MightyMirko/SS2018_HIT_web/CSS/readme.txt

1. Extras.css in Ordner CSS kopieren.

2. CSS in Vorlage einfügen - Die letzte Zeile:

<link href="CSS/Design.css" media="screen" rel="stylesheet" type="text/css" />
<link href="CSS/default.css" media="print" rel="stylesheet" type="text/css" />
<link href="CSS/Extras.css" media="screen" rel="stylesheet" type="text/css" />

3. Bild einfügen:

<p class="iimageFrame">
	Error
	<br>BILDUNTERSCHRIFT
</p>
