MightyMirko/SS2018_HIT_web/data/180307_blackbox.pptx

System1
Output
Input
Störung
Restriktionen
EMV
Förderband 0/1
VDE
Geld
Luft
Daten
Warme Luft
Versorgung 230V
Datenüber-tragung

Energie

Signal

Stoff

## Slide 2

Schuko Steckdosenleiste 230V mit USB 5A

Schaltnetzteil 230V/24V 7.5A

24
5
3.3
PE

Control box

Platine

ESP32-2

ESP32-1

4x
Relais
Shield

## Slide 3

Steuerungspanel

OLED Display

OLED Display

Poti
Taster

SD CARD

SD CARD

## Slide 4

NOT AUS

## Slide 5

HAUPT SCHALTER

## Slide 6

System1
Output
Input
Störung
Restriktionen
EMV
Förderband 0/1
VDE
24V
Geld
Kalte Luft
Temperatur, Luftfeuchte, Drucker Taster 1,2
Warme Luft
Versorgung 230V
Datenübertragung

Energie

Signal

Stoff

## Slide 7

Daten

Energie

SPS
Förderband

FI

Not Aus

Haupt-schalter

Endschalter = 1

Drucker

Schalt-schrank

Messwerte

Display

Poti

SD Card
