MightyMirko/SS2018_HIT_web/data/aa_ss18/180307_blackbox.pptx

System1
Output
Input
Störung
Restriktionen
EMV
Förderband 0/1
VDE
Geld
Luft
Daten
Warme Luft
Versorgung 230V
Datenübertragung

Energie

Signal

Stoff

## Slide 2

NOT AUS

## Slide 3

HAUPT SCHALTER

## Slide 4

Schuko Steckdosenleiste 230V mit USB 5A

Schaltnetzteil 230V/24V 7.5A

24
5
3.3
PE

Control box

Platine

ESP32-2

ESP32-1

4x
Relais
Shield

## Slide 5

Steuerungspanel

OLED Display

OLED Display

Poti
Taster

SD CARD

SD CARD

## Slide 6

System1
Output
Input
Störung
Restriktionen
EMV
Förderband 0/1
VDE
24V
Geld
Kalte Luft
Temperatur, Luftfeuchte, Drucker Taster 1,2
Warme Luft
Versorgung 230V
Datenübertragung

Energie

Signal

Stoff
