MightyMirko/SS2018_HIT_web/data/20180405_eagle_platinenMajo_rev1/layer.png

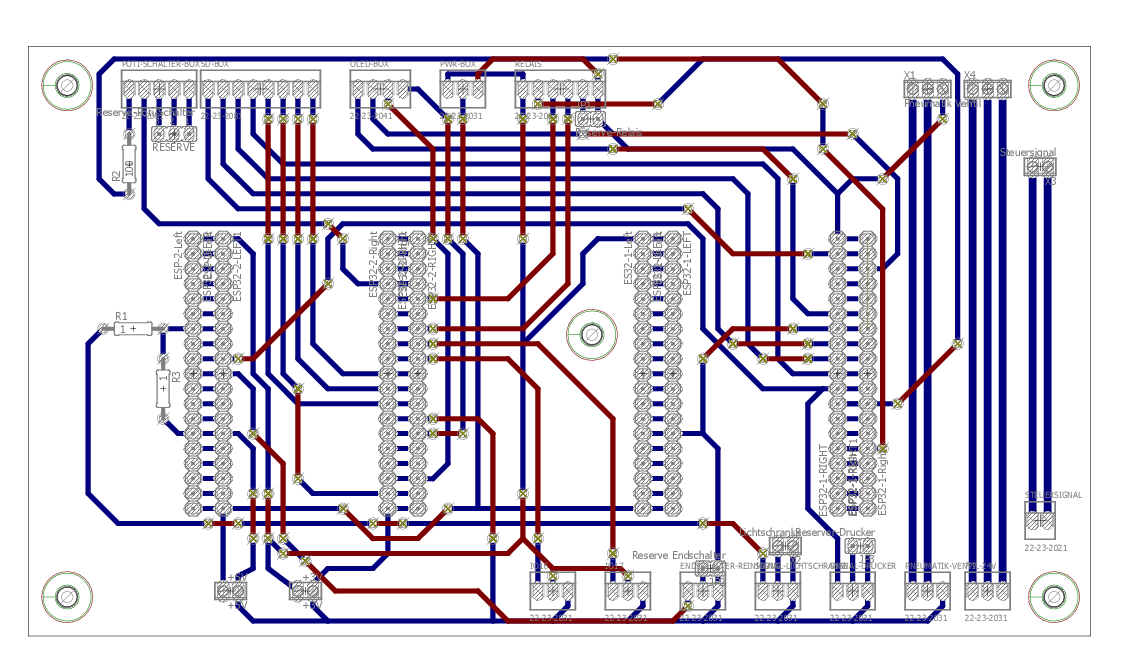
data/20180405_eagle_platinenMajo_rev1/layer.png
