MightyMirko/SS2018_HIT_web/data/20180520_eagle_platinenMajo_rev2/Schaltplan.PNG

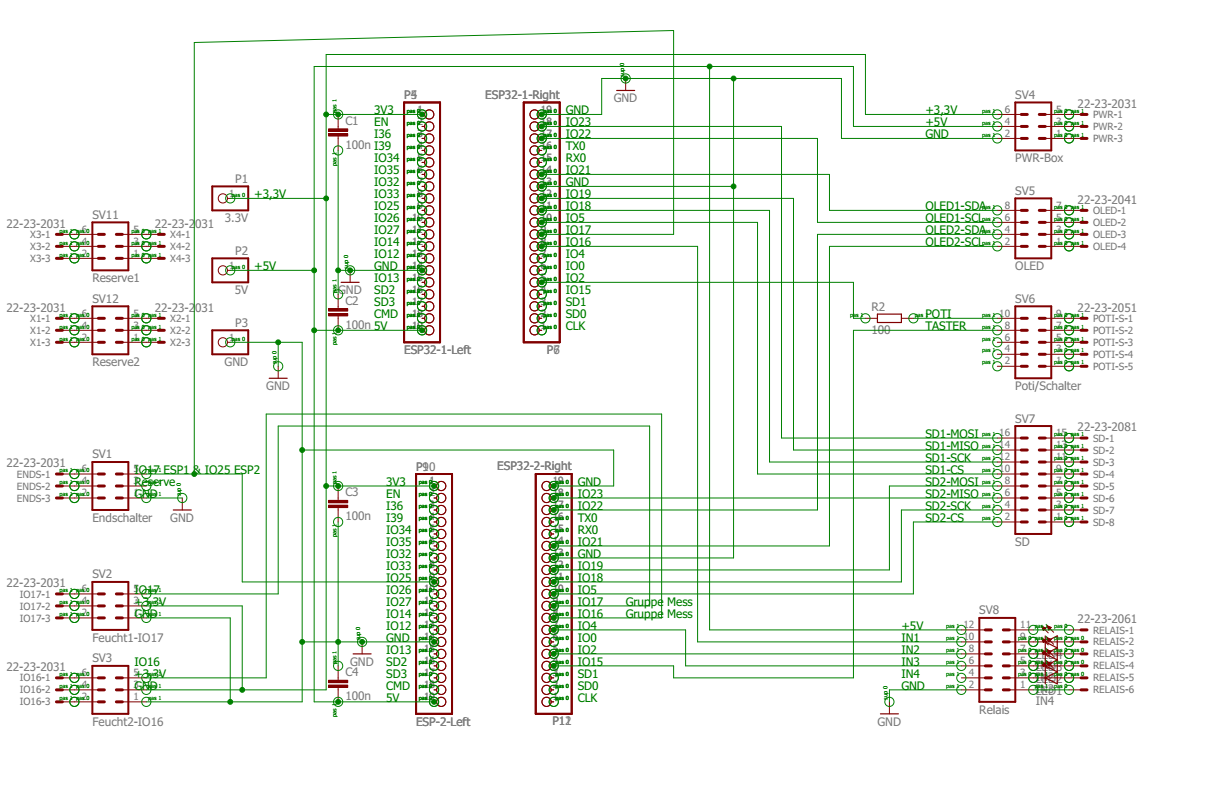
data/20180520_eagle_platinenMajo_rev2/Schaltplan.PNG
