MightyMirko/SS2018_HIT_web/data/20180520_eagle_platinenMajo_rev2/Uebersicht-mitLED.PNG

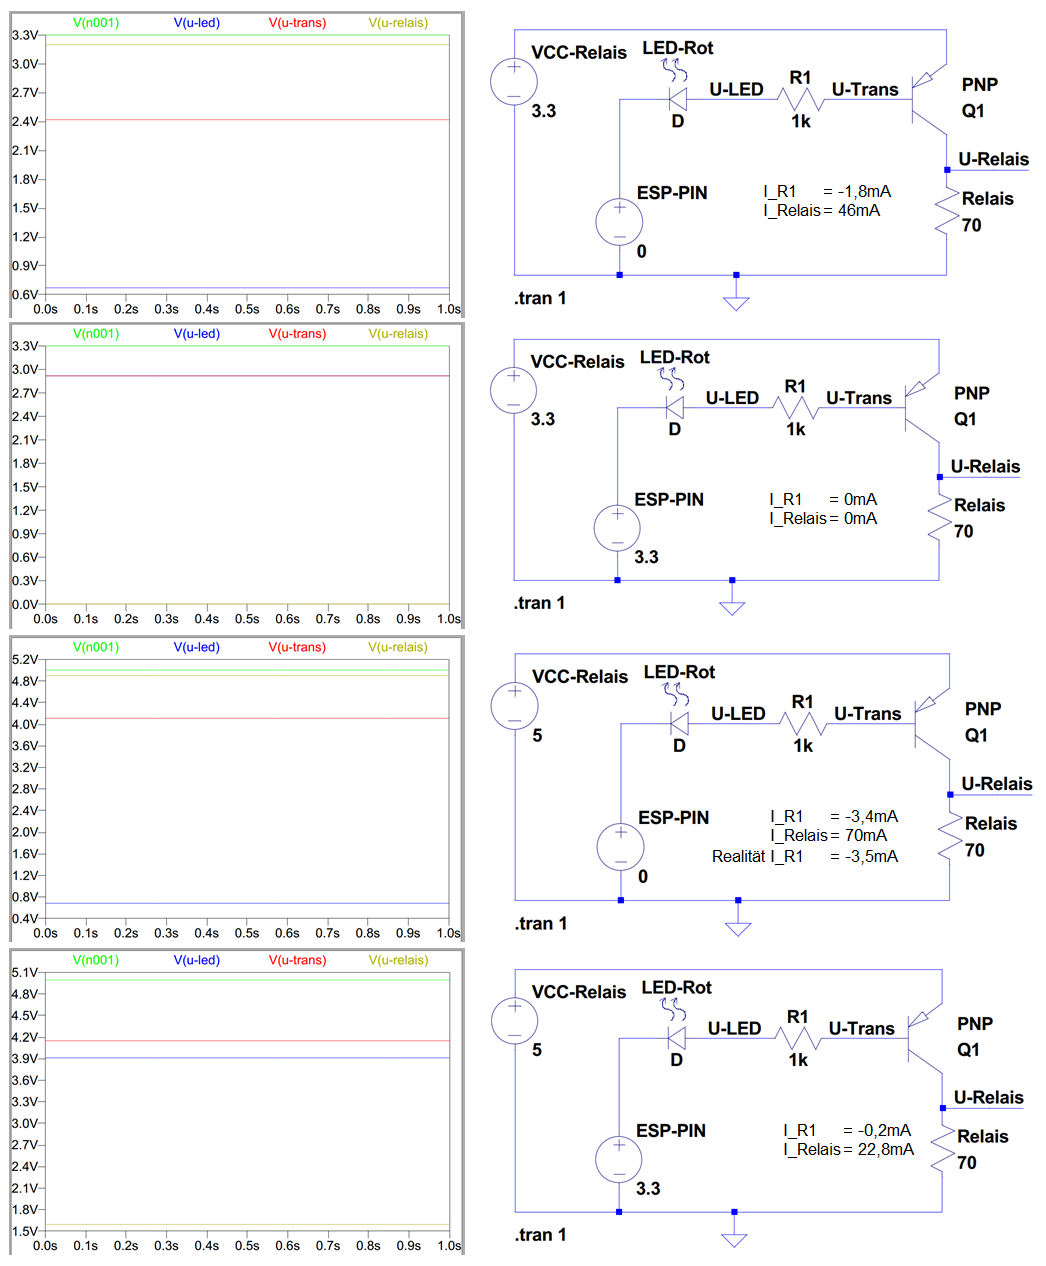
data/20180520_eagle_platinenMajo_rev2/Uebersicht-mitLED.PNG
