MightyMirko/SS2018_HIT_web/images/AA_ss18/20180306_kickoff.jpg

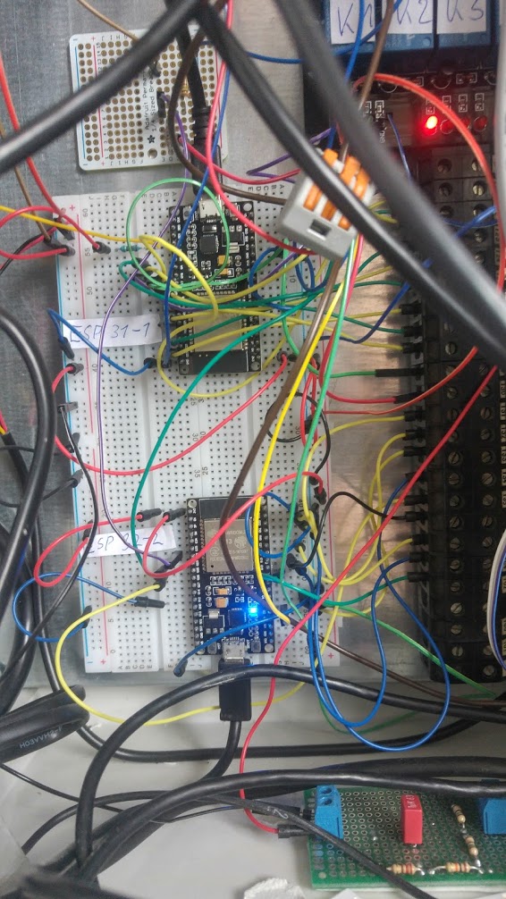
images/AA_ss18/20180306_kickoff.jpg
