MightyMirko/SS2018_HIT_web/images/AA_ss18/20180418_blackbox/Folie3.PNG

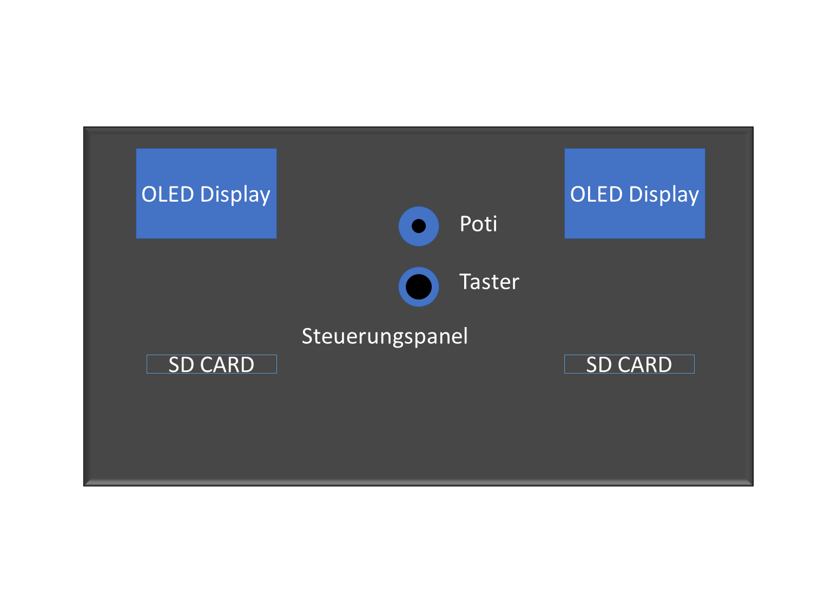
images/AA_ss18/20180418_blackbox/Folie3.PNG
