MightyMirko/SS2018_HIT_web/images/AA_ss18/20180418_blackbox/Folie7.PNG

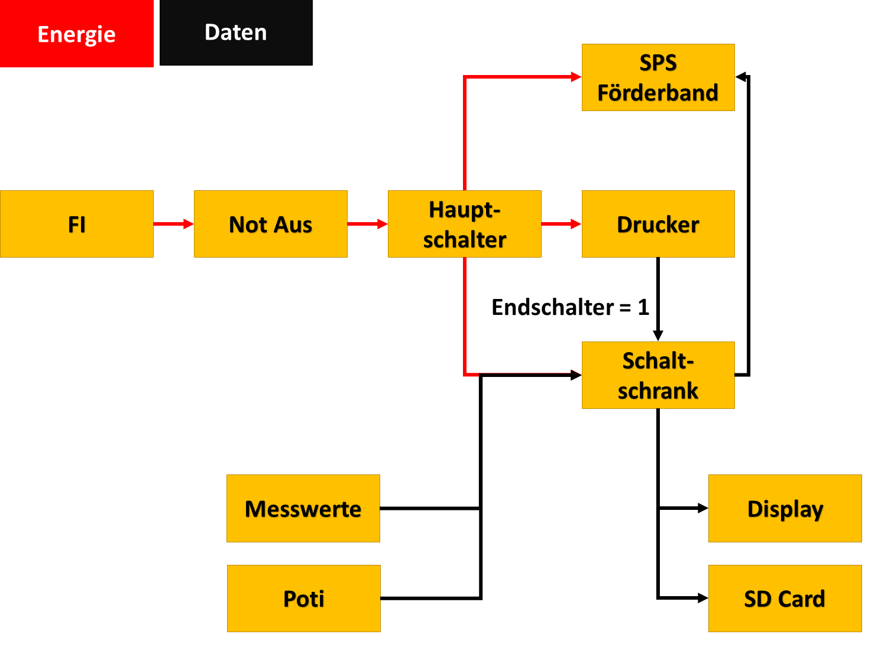
images/AA_ss18/20180418_blackbox/Folie7.PNG
