MightyMirko/SS2018_HIT_web/images/AA_ss18/20180418_Majolika-brainstorming.png

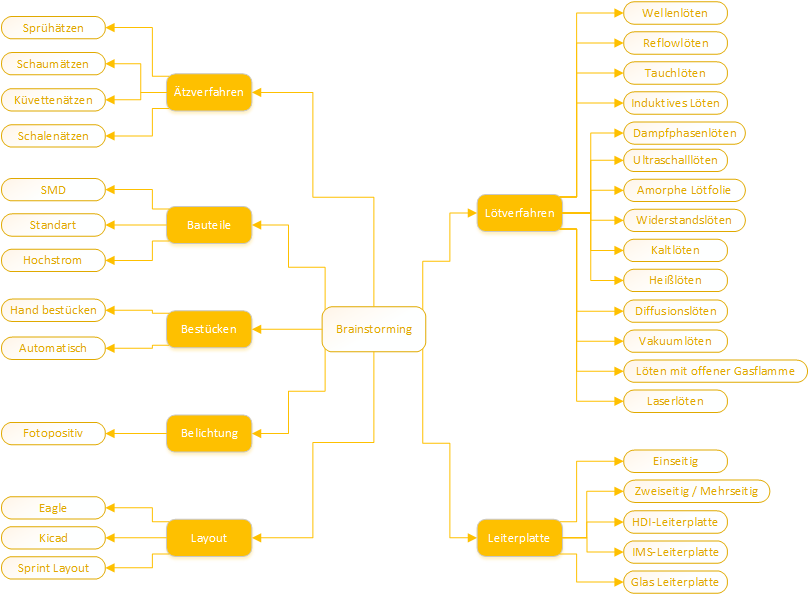
images/AA_ss18/20180418_Majolika-brainstorming.png
