MightyMirko/SS2018_HIT_web/images/AA_ss18/20180430_FinalCountdown/platine_top_placed.jpg

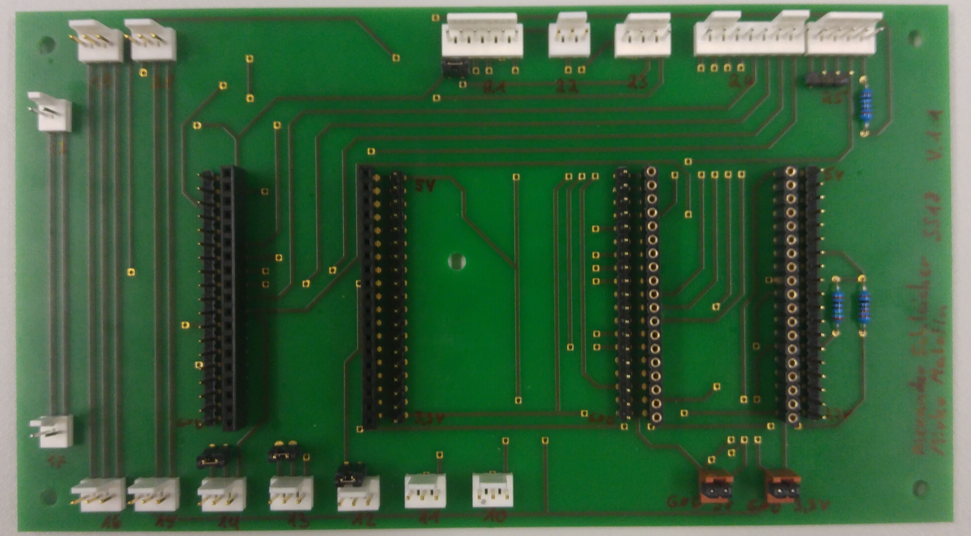
images/AA_ss18/20180430_FinalCountdown/platine_top_placed.jpg
