MightyMirko/SS2018_HIT_web/images/AA_ss18/20180430_FinalCountdown/schaltkasten_.jpg

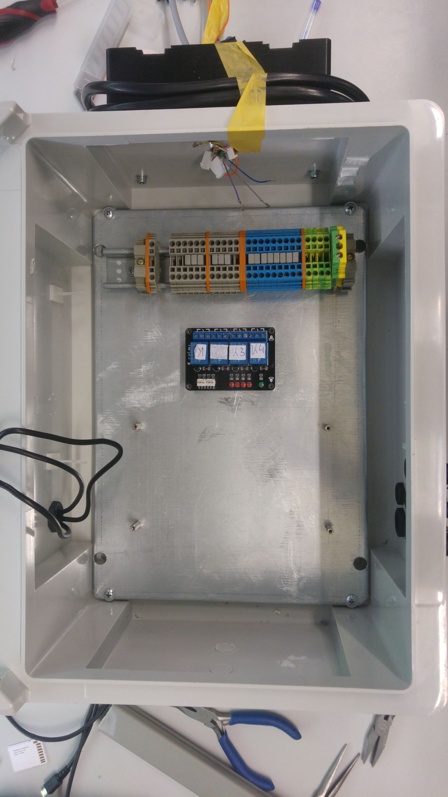
images/AA_ss18/20180430_FinalCountdown/schaltkasten_.jpg
