MightyMirko/SS2018_HIT_web/images/AA_ss18/Alex.png

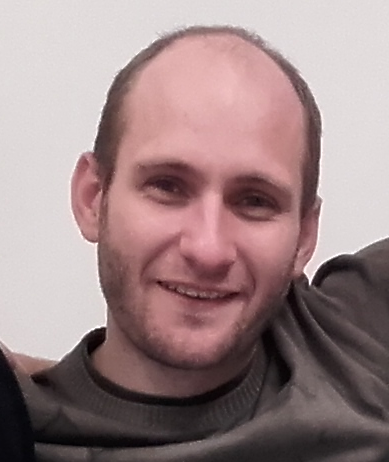
images/AA_ss18/Alex.png
