MightyMirko/SS2018_HIT_web/images/AA_ss18/blackbelt3d.png

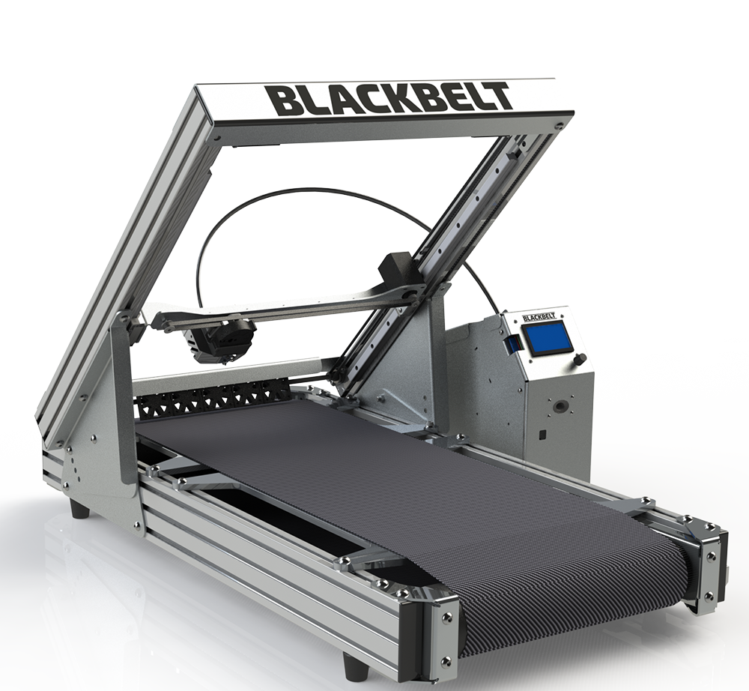
images/AA_ss18/blackbelt3d.png
