MightyMirko/SS2018_HIT_web/images/AA_ss18/blackbox.png

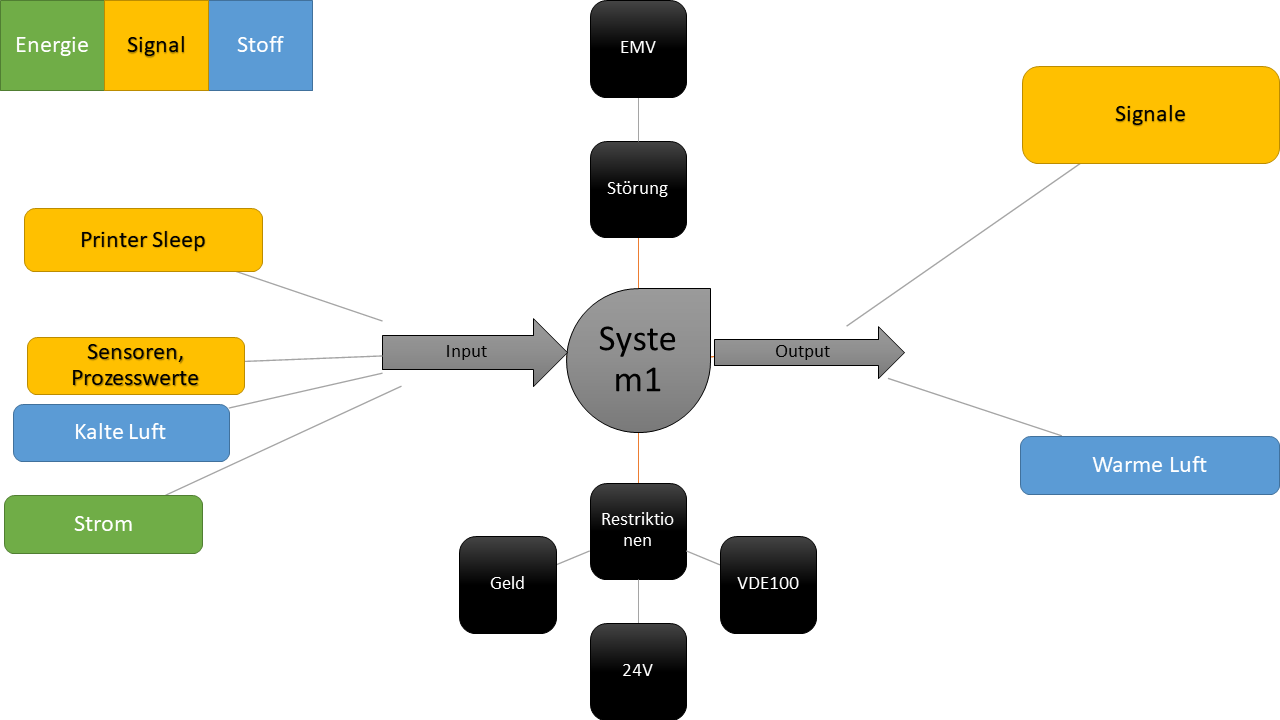
images/AA_ss18/blackbox.png
