MightyMirko/SS2018_HIT_web/images/AA_ss18/Delta-WASP-2040.jpg

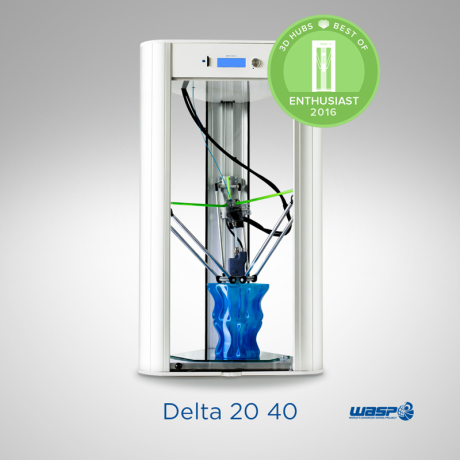
images/AA_ss18/Delta-WASP-2040.jpg
