MightyMirko/SS2018_HIT_web/images/AA_ss18/Mirko_Matosin.jpg

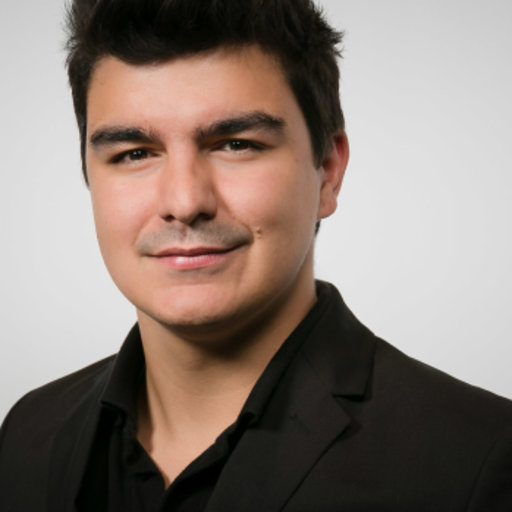
images/AA_ss18/Mirko_Matosin.jpg
