MightyMirko/SS2018_HIT_web/images/AA_ss18/P1010303.JPG

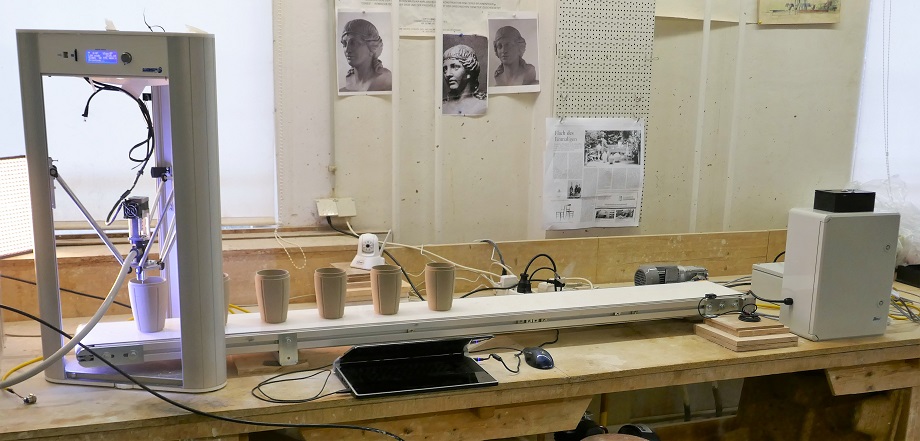
images/AA_ss18/P1010303.JPG
