MightyMirko/SS2018_HIT_web/images/AA_ss18/SimplePro_HeatedBed.Main_.png

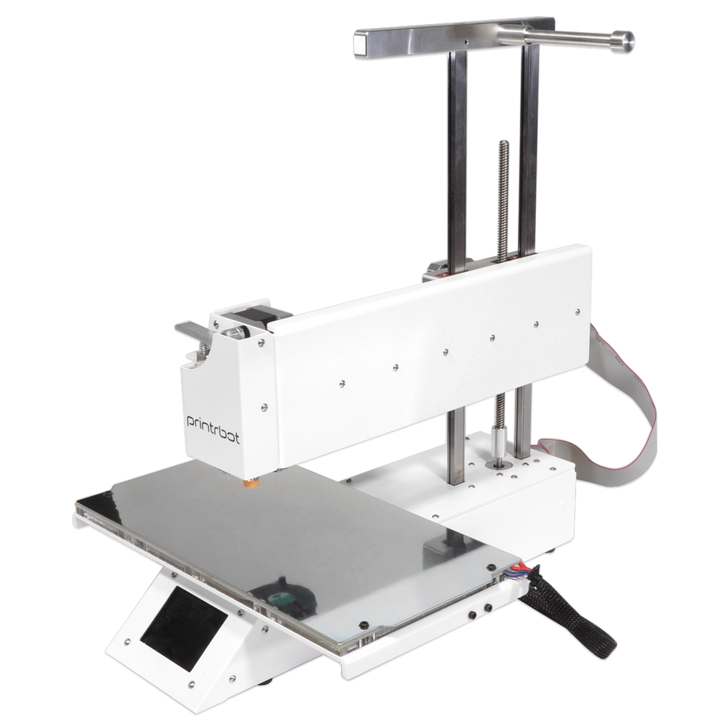
images/AA_ss18/SimplePro_HeatedBed.Main_.png
