MightyMirko/SS2018_HIT_web/images/AA_ss18/Ultimaker.jpg

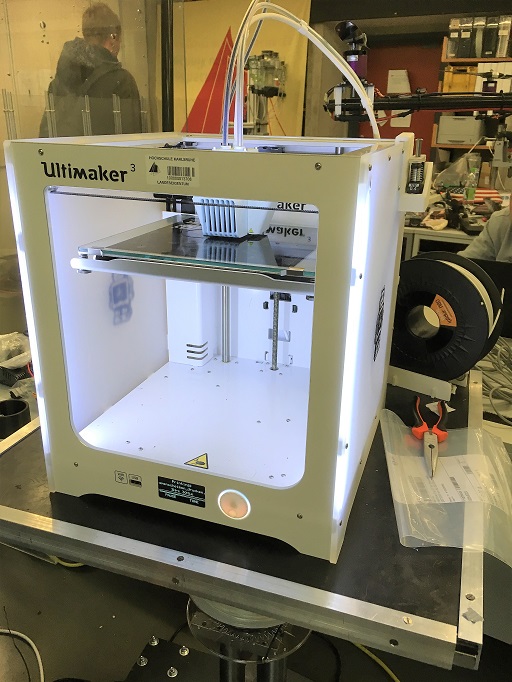
images/AA_ss18/Ultimaker.jpg
