MightyMirko/SS2018_HIT_web/images/netzteil.jpg

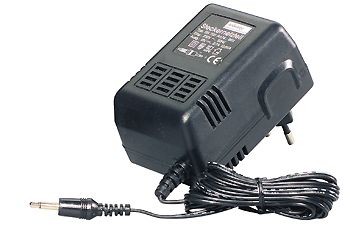
images/netzteil.jpg
