MightyMirko/SS2018_HIT_web/images/platine-brd.png

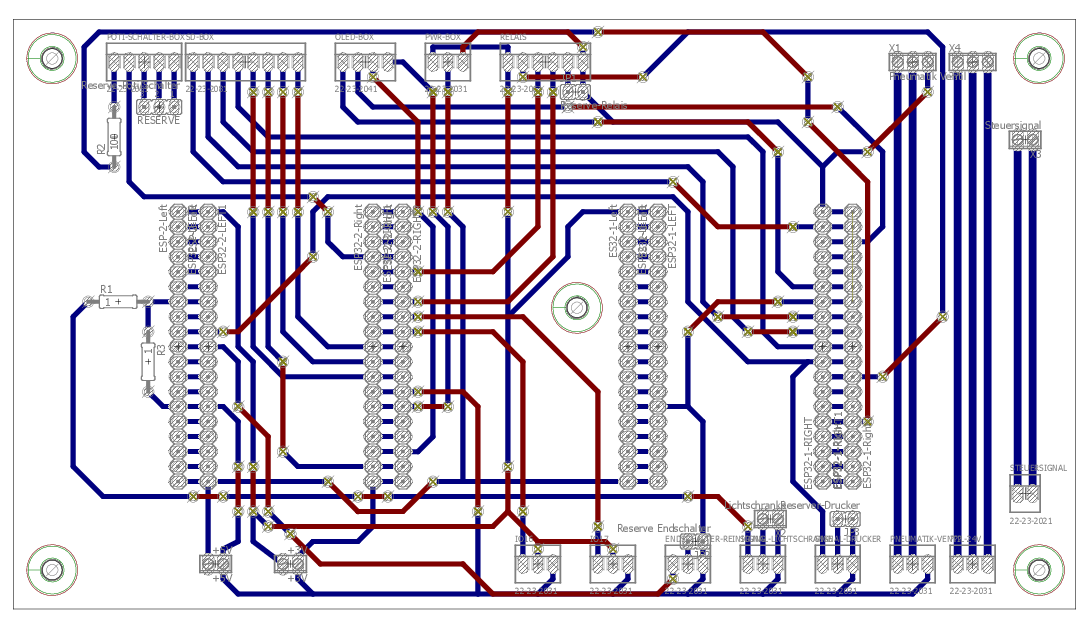
images/platine-brd.png
