MightyMirko/SS2018_HIT_web/images/platine.png

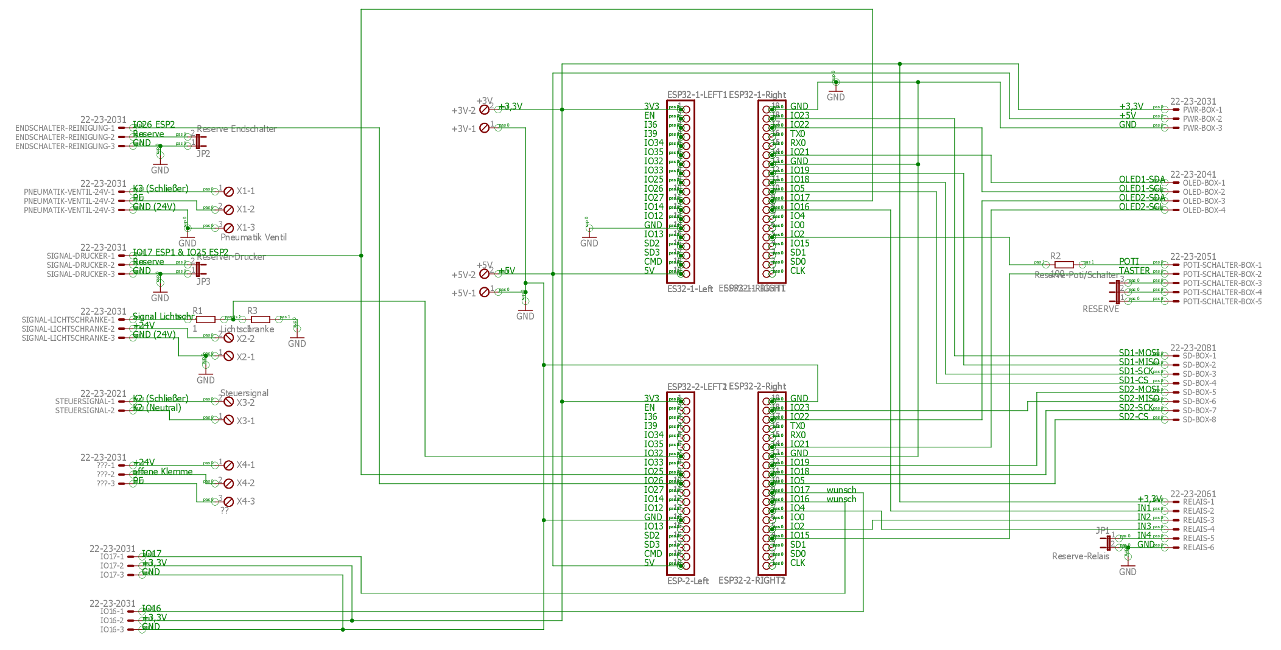
images/platine.png
