MightyMirko/SS2018_HIT_web/data/aa_ss18/20180520_bom_platineMajo_rev2.pdf

Pos. | Anz. Firma | Bezeichnung
1 | 150 | Molex | KK - Buchse, Crimpkontakt, für Serie 2759 AWG 30-22
2 | 6 | Molex | 1x3 Crimpgehäuse, 2.54mm
3 | 10 | Molex | 1x3 Stifleiste, 2.54mm
4 | 4 | Molex | 1x4 Stiftleiste, 2.54mm
5 | 4 | Molex | 1x5 Stiftleiste, 2.54mm
6 | 4 | Molex | 1x6 Stiftleiste, 2.54mm
7 | 4 | Molex | 1x8 Stiftleiste, 2.54mm
8 | 4 | Reichelt | Stiftleisten 2,54 mm, 2x50, gerade
9 | 6 | Reichelt | Stiftleisten 2,54 mm, 1X50, gerade
10 | 5 | Reichelt | Buchsenleisten 2,54 mm, 1X50, gerade
11 | 50 | Reichelt | Kurzschlussbrücke (Jumper), schwarz, RM 2,54
12 | 5 | Yageo | Folienkondensator, 100nF, 100V, 100°C
13 | 5 | Reichelt | LED, 3 mm, bedrahtet, 5 V, rot, 20 mcd, 60°
| | Gesamtsumme ohne MwSt
| | Gesamtsumme mit MwSt
15 | 1 PSK | | Crimpzange PSK AWG18...22 (0.30...0.80 mm²) und
16 | 2 Carry | | Stiftleisten 2,54 mm, 1X36, gerade
17 | 1 Carry | | Buchsenleisten 2,54 mm, 1X50, gerade
18 | 10 Reichelt | | Kurzschlussbrücke, schwarz, RM 2,54
19 | 10 Reichelt | | Distanzhülsen, Metall, 6-Kant, M3, 18mm
20 | 1 Reichelt | | Steuerleitung 10x0,14mm², geschirmt, 5m-Ring
21 | 1 Reichelt | | Sechskantmuttern, M3
22 | 1 Reisser | | Federringe, 3 mm
23 | 10 Reichelt | | Kabeldriller, Innen Ø 7,6 - 10,2 mm, natur
24 | 2 Yageo | | Widerstand, Metallschicht, 100 Ohm, 0207, 0,6 W, 1%
25 | 2 Yageo | | Widerstand, Metallschicht, 732 Ohm, 0207, 0,6 W, 1%
26 | 2 Yageo | | Widerstand, Metallschicht, 470 Ohm, 0207, 0,6 W, 1%
27 | 1 Tesa | | Montageband tesa Powerbond Ultra Strong, 1,5 m x 19 mm
28 | 1 Reichelt | | Schlauchleitung Trockenraumkabel H05VV F3G1,5 25M
29 | 1 Dplock | | USB 3.0 A Stecker auf A Buchse gewinkelt 90° horizontal
30 | 1 Reichelt | | Schrumpfschlauch-Box, 8m, schwarz, Ø9,5mm
Zwischens
Zwischens
31 | 1 | Elektronik-Steuerleitung LIYCY 4 x 0,14mm², 100m Ring
32 | 1 Eaton | Eaton Not-Aus Taster M22-PV/KC02/IY Komplettgerät, 2Ö
33 | 1 Eaton | Eaton Hauptschalter T0-2-1/I1/SVB Komplettgerät, 20A
34 | 1 | Aderendhülsen isoliert, 1,5mm² / 10mm, schwarz, 100 Stück
35 | 1 Hager | tehalit.BA6 Verdrahtungskanal 40 x 25mm, Länge 2m, steingrau
umme
umme mit

mme ohne
mme mit

Artikelnr | Preis | Preis | Notizen | Shop
MOLEX 8500114 | 0,06 € | 9,00 € rev2.0 | Reichelt
MOLEX 22012035 | 0,10 € | 0,60 € rev2.0 | Reichelt
MOLEX 22292031 | 0,26 € | 2,60 € rev2.0 | Reichelt
MOLEX 22272041 | 0,19 € | 0,76 € rev2.0 | Reichelt
MOLEX 22272051 | 0,22 € | 0,88 € rev2.0 | Reichelt
MOLEX 22272061 | 0,26 € | 1,04 € rev2.0 | Reichelt
MOLEX 22272081 | 0,21 € | 0,84 € rev2.0 | Reichelt
SL 2X50G 2,54 | 0,85 € | 3,40 € rev2.0 | Reichelt
SL 1X50G 2,54 | 0,37 € | 2,22 € rev2.0 | Reichelt
BL 1X50G7 2,54 | 2,20 € | 11,00 € rev2.0 | Reichelt
JUMPER 2,54 SW | 0,01 € | 0,50 € rev2.0 | Reichelt
MMK 100N 100 | 0,14 € | 0,70 € rev2.0 | Reichelt
LED 3MM 5V RT | 0,31 € | 1,55 € | rev2.0 | Reichelt
| 28,42 €
| 35,09 €
CRIMPZANGE PSK | 17,80 € | 17,80 € | | Reichelt
MPE 087-1-036 | 0,56 € | 1,12 € | ESP32 | Reichelt
MPE 115-1-050 | 2,30 € | 2,30 € | | Reichelt
JUMPER 2,54 SW | 0,01 € | 0,10 € | | Reichelt
DA 18MM | 0,15 € | 1,50 € | | Reichelt
LIYCY 10-5 | 4,80 € | 4,80 € | | Reichelt
SK M3 | 0,99 € | 0,99 € | | Reichelt
SFR 3-100 | 0,99 € | 0,99 € | | Reichelt
KAB-DRILLER SK1 | 0,22 € | 2,20 € | | Reichelt
METALL 100 | 0,08 € | 0,16 € | Reichelt
METALL 732 | 0,08 € | 0,16 € | Reichelt
METALL 470 | 0,08 € | 0,16 € | Reichelt
TESA 55791 | 6,40 € | 6,40 € | Reichelt
H05VV F3G1,5 25M | 23,95 € | 23,95 € | Reichelt
DELOCK 65341 | 4,95 € | 4,95 € | Reichelt
SDB 9,5 SW | 2,85 € | 2,85 € | Reichelt
| | 129,63 €
160,04 €
10800103 | 28,95 € | 28,95 € | | ElektroSchmidt
216524 | 35,66 € | 35,66 € | VDE100 | ElektroSchmidt
207147 | 31,40 € | 31,40 € | VDE100 | ElektroSchmidt
472/10 | 2,04 € | 2,04 € | ElektroSchmidt
BA64002507030B | 7,69 € | 2,04 € | ElektroSchmidt
| | 81,07 €
100,09 €

210,71 €
260,13 €

https://www.reichelt.de/Molex-Vielfachsteckverbinder/MOLEX-8500114/3/index.html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
https://www.reichelt.de/MOLEX-22292031/3/index.html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;ARTICLE=54090;SEARCH=led%203mm

https://www.reichelt.de/Crimpzangen/CRIMPZANGE-PSK/3/index.html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;ARTICLE=53761;SEARCH=SDB%209,5%20SW

https://www.elektroversand-schmidt.de/product_info.php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
