MightyMirko/SS2018_HIT_web/data/20180520_eagle_platinenMajo_rev2/bom_v2.xlsx

Pos. | Anz. | Firma | Bezeichnung | Artikelnr | Preis pro | Preis | Notizen | Shop
1 | 150 | Molex | KK - Buchse, Crimpkontakt, für Serie 2759 AWG 30-22 | MOLEX 8500114 | 0.06 € | 9.00 € | Signal Crimp | Reichelt | https://www.reichelt.de/Molex-Vielfachsteckverbinder/MOLEX-8500114/3/index.html?ACTION=3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
2 | 6 | Molex | 1x3 Crimpgehäuse, 2.54mm | MOLEX 22012035 | 0.10 € | 0.60 € |  | Reichelt | https://www.reichelt.de/MOLEX-22012035/3/index.html?ACTION=3&LA=55&ARTICLE=185651
3 | 10 | Molex | 1x3 Stifleiste, 2.54mm | MOLEX 22292031 | 0.26 € | 2.60 € |  | Reichelt | https://www.reichelt.de/MOLEX-22292031/3/index.html?ACTION=3&LA=55&ARTICLE=190285
4 | 4 | Molex | 1x4 Stiftleiste, 2.54mm | MOLEX 22272041 | 0.19 € | 0.76 € |  | Reichelt | https://www.reichelt.de/Molex-Vielfachsteckverbinder/MOLEX-22272041/3/index.html?ACTION=3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
5 | 4 | Molex | 1x5 Stiftleiste, 2.54mm | MOLEX 22272051 | 0.22 € | 0.88 € |  | Reichelt | https://www.reichelt.de/MOLEX-22272051/3/index.html?ACTION=3&LA=55&ARTICLE=185660
6 | 4 | Molex | 1x6 Stiftleiste, 2.54mm | MOLEX 22272061 | 0.26 € | 1.04 € |  | Reichelt | https://www.reichelt.de/Molex-Vielfachsteckverbinder/MOLEX-22272061/3/index.html?ACTION=3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
7 | 4 | Molex | 1x8 Stiftleiste, 2.54mm | MOLEX 22272081 | 0.21 € | 0.84 € |  | Reichelt | https://www.reichelt.de/MOLEX-22272081/3/index.html?ACTION=3&LA=55&ARTICLE=185662
8 | 4 | Reichelt | Stiftleisten 2,54 mm, 2x50, gerade | SL 2X50G 2,54 | 0.85 € | 3.40 € |  | Reichelt | https://www.reichelt.de/Stiftleisten/SL-2X50G-2-54/3/index.html?ACTION=3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
9 | 6 | Reichelt | Stiftleisten 2,54 mm, 1X50, gerade | SL 1X50G 2,54 | 0.37 € | 2.22 € | ESP32 | Reichelt | https://www.reichelt.de/Stiftleisten/SL-1X50G-2-54/3/index.html?ACTION=3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
10 | 5 | Reichelt | Buchsenleisten 2,54 mm, 1X50, gerade | BL 1X50G7 2,54 | 2.20 € | 11.00 € |  | Reichelt | https://www.reichelt.de/Buchsenleisten/BL-1X50G7-2-54/3/index.html?ACTION=3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
11 | 50 | Reichelt | Kurzschlussbrücke (Jumper), schwarz, RM 2,54 | JUMPER 2,54 SW | 0.01 € | 0.50 € |  | Reichelt | https://www.reichelt.de/Stiftleisten/JUMPER-2-54-SW/3/index.html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
12 | 5 | Yageo | Folienkondensator, 100nF, 100V, 100°C | MMK 100N 100 | 0.14 € | 0.70 € |  | Reichelt | https://www.reichelt.de/Kemet/MMK-100N-100/3/index.html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
13 | 5 | Reichelt | LED, 3 mm, bedrahtet, 5 V, rot, 20 mcd, 60° | LED 3MM 5V RT | 0.31 € | 1.55 € |  | Reichelt | https://www.reichelt.de/directlink/LED/index.html?ACTION=3;ARTICLE=54090;SEARCH=led%203mm
 |  | Gesamtsumme ohne MwSt |  |  |  | 28.42 €
 |  | Gesamtsumme mit MwSt |  |  |  | 35.09 €
