MightyMirko/SS2018_HIT_web/data/aa_ss18/20180520_bom_platineMajo_rev2.xlsx

Pos. | Anz. | Firma | Bezeichnung | Artikelnr | Preis pro | Preis | Notizen | Shop
1 | 150 | Molex | KK - Buchse, Crimpkontakt, für Serie 2759 AWG 30-22 | MOLEX 8500114 | 0.06 € | 9.00 € | rev2.0 | Reichelt | https://www.reichelt.de/Molex-Vielfachsteckverbinder/MOLEX-8500114/3/index.html?ACTION=3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
2 | 6 | Molex | 1x3 Crimpgehäuse, 2.54mm | MOLEX 22012035 | 0.10 € | 0.60 € | rev2.0 | Reichelt | https://www.reichelt.de/MOLEX-22012035/3/index.html?ACTION=3&LA=55&ARTICLE=185651
3 | 10 | Molex | 1x3 Stifleiste, 2.54mm | MOLEX 22292031 | 0.26 € | 2.60 € | rev2.0 | Reichelt | https://www.reichelt.de/MOLEX-22292031/3/index.html?ACTION=3&LA=55&ARTICLE=190285
4 | 4 | Molex | 1x4 Stiftleiste, 2.54mm | MOLEX 22272041 | 0.19 € | 0.76 € | rev2.0 | Reichelt | https://www.reichelt.de/Molex-Vielfachsteckverbinder/MOLEX-22272041/3/index.html?ACTION=3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
5 | 4 | Molex | 1x5 Stiftleiste, 2.54mm | MOLEX 22272051 | 0.22 € | 0.88 € | rev2.0 | Reichelt | https://www.reichelt.de/MOLEX-22272051/3/index.html?ACTION=3&LA=55&ARTICLE=185660
6 | 4 | Molex | 1x6 Stiftleiste, 2.54mm | MOLEX 22272061 | 0.26 € | 1.04 € | rev2.0 | Reichelt | https://www.reichelt.de/Molex-Vielfachsteckverbinder/MOLEX-22272061/3/index.html?ACTION=3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
7 | 4 | Molex | 1x8 Stiftleiste, 2.54mm | MOLEX 22272081 | 0.21 € | 0.84 € | rev2.0 | Reichelt | https://www.reichelt.de/MOLEX-22272081/3/index.html?ACTION=3&LA=55&ARTICLE=185662
8 | 4 | Reichelt | Stiftleisten 2,54 mm, 2x50, gerade | SL 2X50G 2,54 | 0.85 € | 3.40 € | rev2.0 | Reichelt | https://www.reichelt.de/Stiftleisten/SL-2X50G-2-54/3/index.html?ACTION=3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
9 | 6 | Reichelt | Stiftleisten 2,54 mm, 1X50, gerade | SL 1X50G 2,54 | 0.37 € | 2.22 € | rev2.0 | Reichelt | https://www.reichelt.de/Stiftleisten/SL-1X50G-2-54/3/index.html?ACTION=3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
10 | 5 | Reichelt | Buchsenleisten 2,54 mm, 1X50, gerade | BL 1X50G7 2,54 | 2.20 € | 11.00 € | rev2.0 | Reichelt | https://www.reichelt.de/Buchsenleisten/BL-1X50G7-2-54/3/index.html?ACTION=3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
11 | 50 | Reichelt | Kurzschlussbrücke (Jumper), schwarz, RM 2,54 | JUMPER 2,54 SW | 0.01 € | 0.50 € | rev2.0 | Reichelt | https://www.reichelt.de/Stiftleisten/JUMPER-2-54-SW/3/index.html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
12 | 5 | Yageo | Folienkondensator, 100nF, 100V, 100°C | MMK 100N 100 | 0.14 € | 0.70 € | rev2.0 | Reichelt | https://www.reichelt.de/Kemet/MMK-100N-100/3/index.html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
13 | 5 | Reichelt | LED, 3 mm, bedrahtet, 5 V, rot, 20 mcd, 60° | LED 3MM 5V RT | 0.31 € | 1.55 € | rev2.0 | Reichelt | https://www.reichelt.de/directlink/LED/index.html?ACTION=3;ARTICLE=54090;SEARCH=led%203mm
 |  | Gesamtsumme ohne MwSt |  |  |  | 28.42 €
 |  | Gesamtsumme mit MwSt |  |  |  | 35.09 €
15 | 1 | PSK | Crimpzange PSK AWG18...22 (0.30...0.80 mm²) und AWG24...30 (0.05...0.20 mm²) | CRIMPZANGE PSK | 17.80 € | 17.80 € |  | Reichelt | https://www.reichelt.de/Crimpzangen/CRIMPZANGE-PSK/3/index.html?ACTION=3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
16 | 2 | Carry | Stiftleisten 2,54 mm, 1X36, gerade | MPE 087-1-036 | 0.56 € | 1.12 € | ESP32 | Reichelt | https://www.reichelt.de/Stiftleisten/MPE-087-1-036/3/index.html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
17 | 1 | Carry | Buchsenleisten 2,54 mm, 1X50, gerade | MPE 115-1-050 | 2.30 € | 2.30 € |  | Reichelt | https://www.reichelt.de/Buchsenleisten/MPE-115-1-050/3/index.html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
18 | 10 | Reichelt | Kurzschlussbrücke, schwarz, RM 2,54 | JUMPER 2,54 SW | 0.01 € | 0.10 € |  | Reichelt | https://www.reichelt.de/Stiftleisten/JUMPER-2-54-SW/3/index.html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
19 | 10 | Reichelt | Distanzhülsen, Metall, 6-Kant, M3, 18mm | DA 18MM | 0.15 € | 1.50 € |  | Reichelt | https://www.reichelt.de/Distanzhuelsen-etc-/DA-18MM/3/index.html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
20 | 1 | Reichelt | Steuerleitung 10x0,14mm², geschirmt, 5m-Ring | LIYCY 10-5 | 4.80 € | 4.80 € |  | Reichelt | https://www.reichelt.de/Steuerleitung/LIYCY-10-5/3/index.html?ACTION=3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
21 | 1 | Reichelt | Sechskantmuttern, M3 | SK M3 | 0.99 € | 0.99 € |  | Reichelt | https://www.reichelt.de/SK-M3/3/index.html?ACTION=3&LA=55&ARTICLE=18083
22 | 1 | Reisser | Federringe, 3 mm | SFR 3-100 | 0.99 € | 0.99 € |  | Reichelt | https://www.reichelt.de/Federringe/SFR-3-100/3/index.html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
23 | 10 | Reichelt | Kabeldriller, Innen Ø 7,6 - 10,2 mm, natur | KAB-DRILLER SK1 | 0.22 € | 2.20 € |  | Reichelt | https://www.reichelt.de/Kabeldriller-Kabelbuendler/KAB-DRILLER-SK1/3/index.html?ACTION=3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
24 | 2 | Yageo | Widerstand, Metallschicht, 100 Ohm, 0207, 0,6 W, 1% | METALL 100 | 0.08 € | 0.16 € |  | Reichelt | https://www.reichelt.de/0-6W-1-100-Ohm-976-Ohm/METALL-100/3/index.html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
25 | 2 | Yageo | Widerstand, Metallschicht, 732 Ohm, 0207, 0,6 W, 1% | METALL 732 | 0.08 € | 0.16 € |  | Reichelt | https://www.reichelt.de/0-6W-1-100-Ohm-976-Ohm/METALL-732/3/index.html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
26 | 2 | Yageo | Widerstand, Metallschicht, 470 Ohm, 0207, 0,6 W, 1% | METALL 470 | 0.08 € | 0.16 € |  | Reichelt | https://www.reichelt.de/0-6W-1-100-Ohm-976-Ohm/METALL-470/3/index.html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
27 | 1 | Tesa | Montageband tesa Powerbond Ultra Strong, 1,5 m x 19 mm | TESA 55791 | 6.40 € | 6.40 € |  | Reichelt | https://www.reichelt.de/Montieren-Verlegen/TESA-55791/3/index.html?ACTION=3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
28 | 1 | Reichelt | Schlauchleitung Trockenraumkabel H05VV F3G1,5 25M | H05VV F3G1,5 25M | 23.95 € | 23.95 € |  | Reichelt | https://www.reichelt.de/Kunststoff-Schlauchleitung/H05VV-F3G1-5-25M/3/index.html?ACTION=3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
29 | 1 | Dplock | USB 3.0 A Stecker auf A Buchse gewinkelt 90° horizontal | DELOCK 65341 | 4.95 € | 4.95 € |  | Reichelt | https://www.reichelt.de/USB-Adapter/DELOCK-65341/3/index.html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
30 | 1 | Reichelt | Schrumpfschlauch-Box, 8m, schwarz, Ø9,5mm | SDB 9,5 SW | 2.85 € | 2.85 € |  | Reichelt | https://www.reichelt.de/Warenkorb/5/index.html?ACTION=3;ARTICLE=53761;SEARCH=SDB%209,5%20SW
 |  | Zwischensumme ohne MwSt |  |  |  | 129.63 €
 |  | Zwischensumme mit MwSt |  |  |  | 160.04 €
31 | 1 |  | Elektronik-Steuerleitung LIYCY 4 x 0,14mm², 100m Ring | 10800103 | 28.95 € | 28.95 € |  | ElektroSchmidt | https://www.elektroversand-schmidt.de/product_info.php?products_id=14023
32 | 1 | Eaton | Eaton Not-Aus Taster M22-PV/KC02/IY Komplettgerät, 2Ö | 216524 | 35.66 € | 35.66 € | VDE100 | ElektroSchmidt | https://www.elektroversand-schmidt.de/product_info.php?products_id=41330
33 | 1 | Eaton | Eaton Hauptschalter T0-2-1/I1/SVB Komplettgerät, 20A | 207147 | 31.40 € | 31.40 € | VDE100 | ElektroSchmidt | https://www.elektroversand-schmidt.de/product_info.php?cPath=2_6538_6539_6692_6693_6705&products_id=41856
34 | 1 |  | Aderendhülsen isoliert, 1,5mm² / 10mm, schwarz, 100 Stück | 472/10 | 2.04 € | 2.04 € |  | ElektroSchmidt | https://www.elektroversand-schmidt.de/product_info.php?cPath=0_23_2450_2451&products_id=9380
35 | 1 | Hager | tehalit.BA6 Verdrahtungskanal 40 x 25mm, Länge 2m, steingrau | BA64002507030B | 7.69 € | 2.04 € |  | ElektroSchmidt | https://www.elektroversand-schmidt.de/product_info.php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
 |  | Zwischensumme ohne MwSt |  |  |  | 81.07 €
 |  | Zwischensumme mit MwSt |  |  |  | 100.09 €
 |  | Gesamtsumme ohne MwSt |  |  |  | 210.71 €
 |  | Gesamtsumme mit MwSt |  |  |  | 260.13 €
