MightyMirko/SS2018_HIT_web/data/20180405_eagle_platinenMajo_rev1/3D-Druck-Platine-brd.pdf

JP1

X1

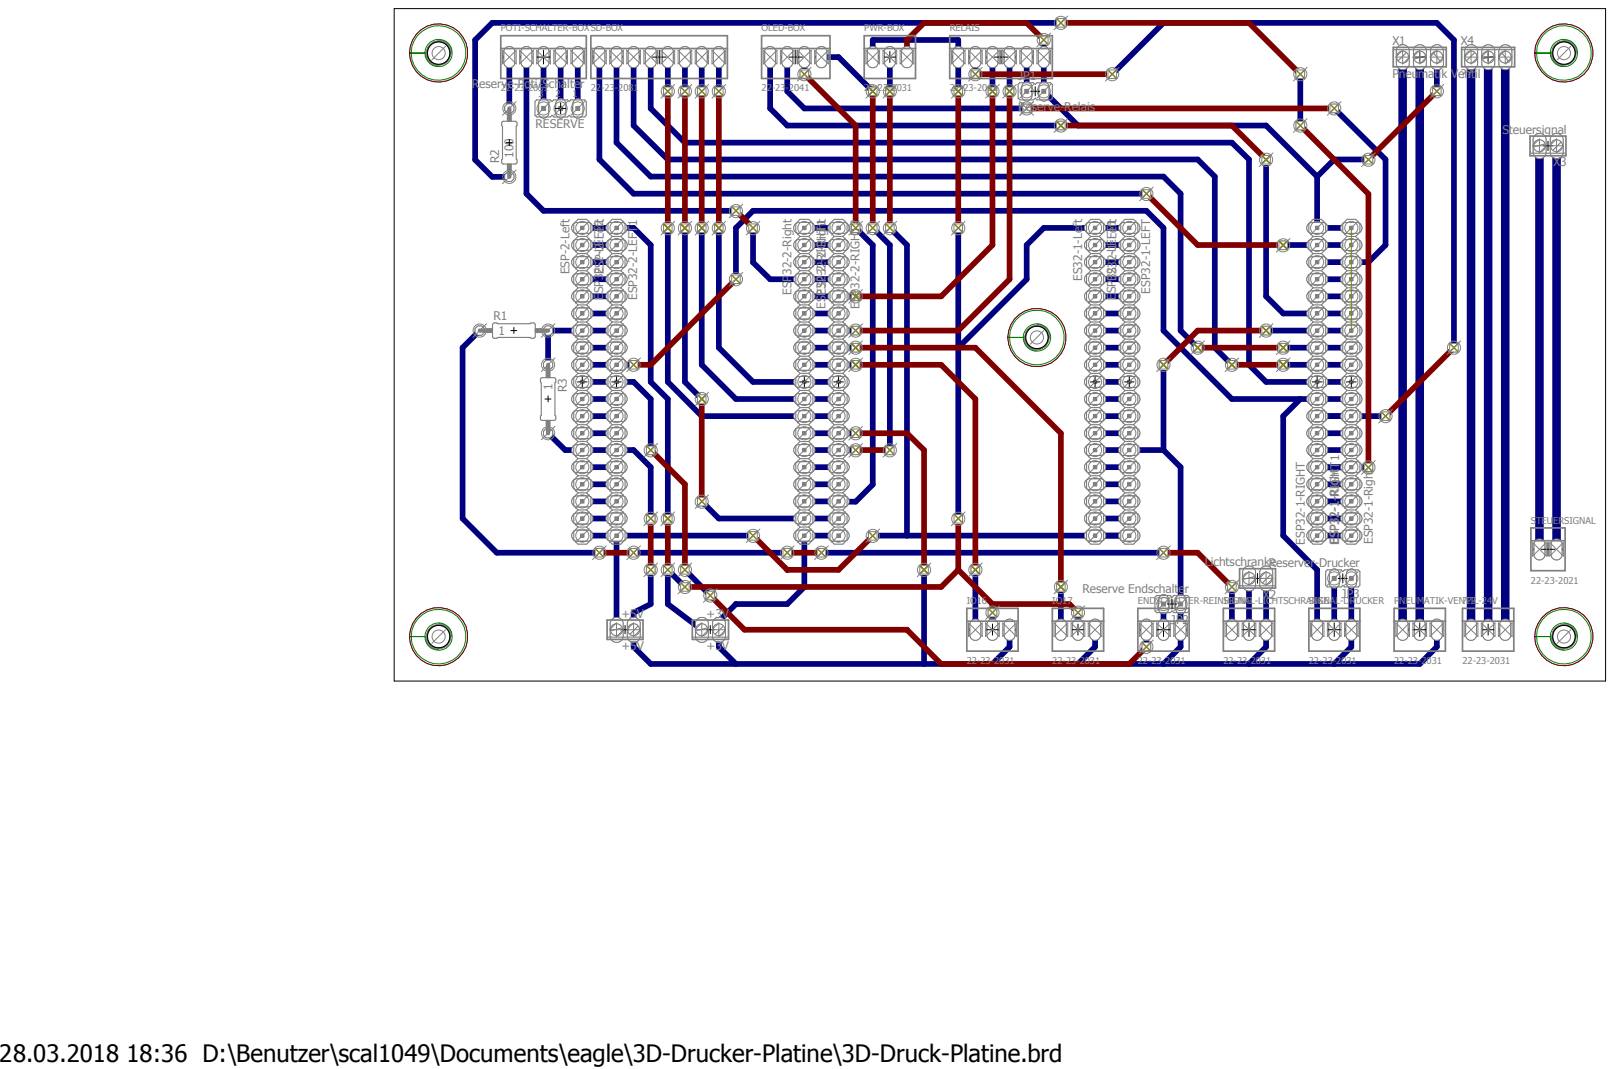
[picture p57: page 1]
28.03.2018 18:36 D:\Benutzer\scal1049\Documents\ea; ENDSCHALTER-REINIGUNG; ESP32-1-LEFT; ESP32-1-RIGHT; ESP32-2-LEFT1; ESP32-2-RIGHT1; OLED-BOX; PNEUMATIK-VENTIL-24V; POTI-SCHALTER-BOX; PWR-BOX; RELAIS; RESERVE; SD-BOX; SIGNAL-LICHTSCHRANKE SIGNAL-DRUCKER; STEUERSIGNAL; ESP32-2-LEFT2; ESP32-2-RIGHT2; ESP32-1-LEFT1; ESP32-1-RIGHT1; ES32-1-Left; ESP32-1-Right; ESP-2-Left; ESP32-2-Right; Reserve-Relais; Reserve Endschalter; Reserver-Drucker; Reserve-Poti/Schalter 22-23-2081; Lichtschranke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
