MightyMirko/SS2018_HIT_web/data/20180405_eagle_platinenMajo_rev1/3D-Druck-Platine.pdf

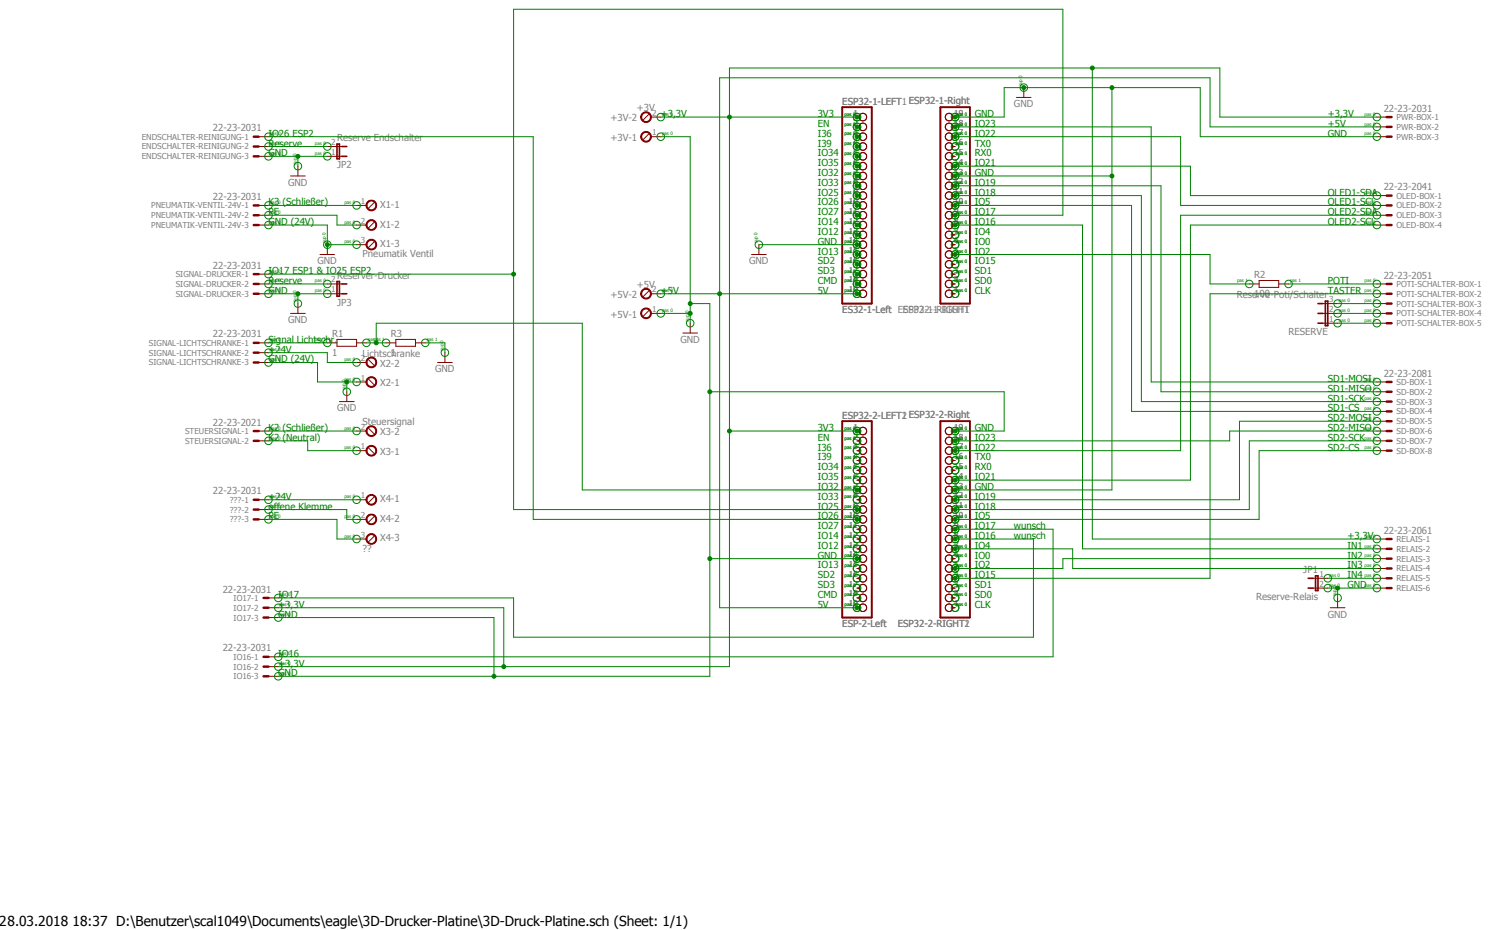
[picture p58: page 1]
28.03.2018 18:37 D:\Benutzer\scal1049\Documents\ea; ES32-1-Left; ESP32-1-Right; GND; ESP-2-Left; ESP32-2-Right; Reserve-Poti/Schalter; Reserve-Relais; Reserve Endschalter; Reserver-Drucker 1; Lichtschranke; Steuersignal; Pneumatik Ventil GND; ESP32-1-LEFT 1 2 3 4 5 6 7 8 9 10 11 12 13 14 15 16 17 18 19; ESP32-1-RIGHT; ESP32-2-LEFT1 1 2 3 4 5 6 7 8 9 10 11 12 13 14 15 16 17 18 19; ESP32-2-RIGHT1; PWR-BOX-1 PWR-BOX-2 PWR-BOX-3 OLED-BOX-1 OLED-BOX-2 OLED-BOX-3 OLED-BOX-4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
