MightyMirko/SS2018_HIT_web/data/20180520_eagle_platinenMajo_rev2/3D-Druck-Platine_v2_0.brd.pdf

1

1

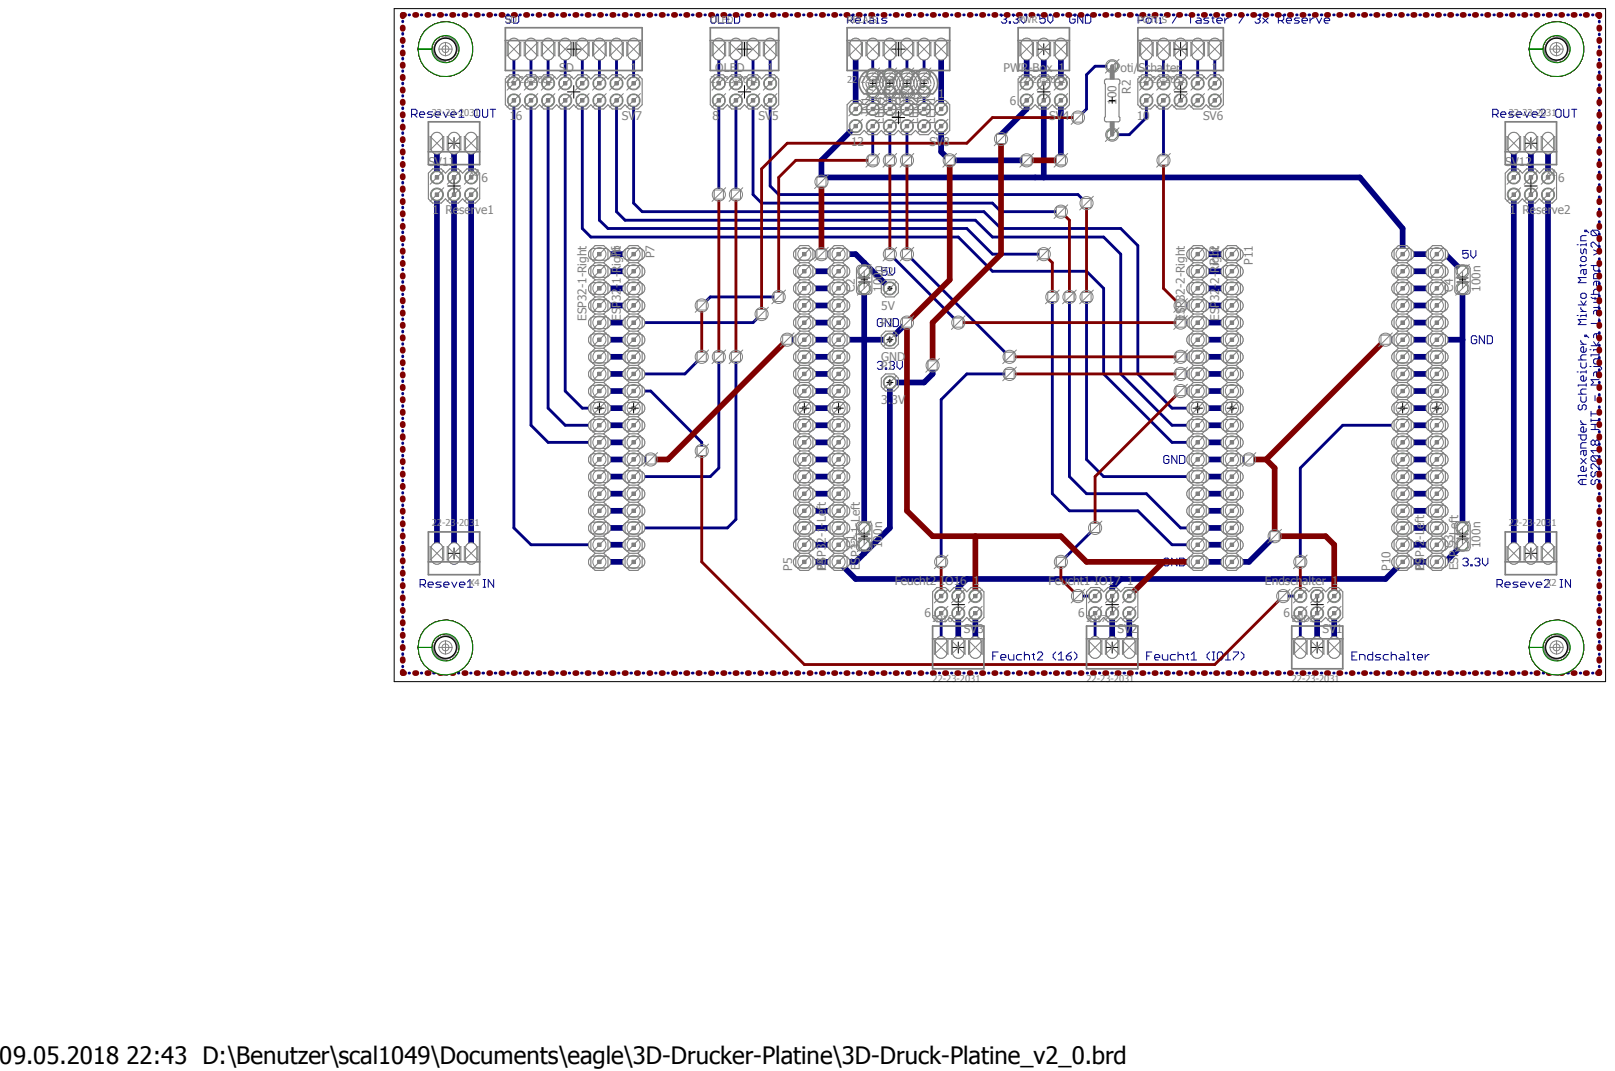
[picture p59: page 1]
