MightyMirko/SS2018_HIT_web/data/20180520_eagle_platinenMajo_rev2/3D-Druck-Platine_v2_0.pdf

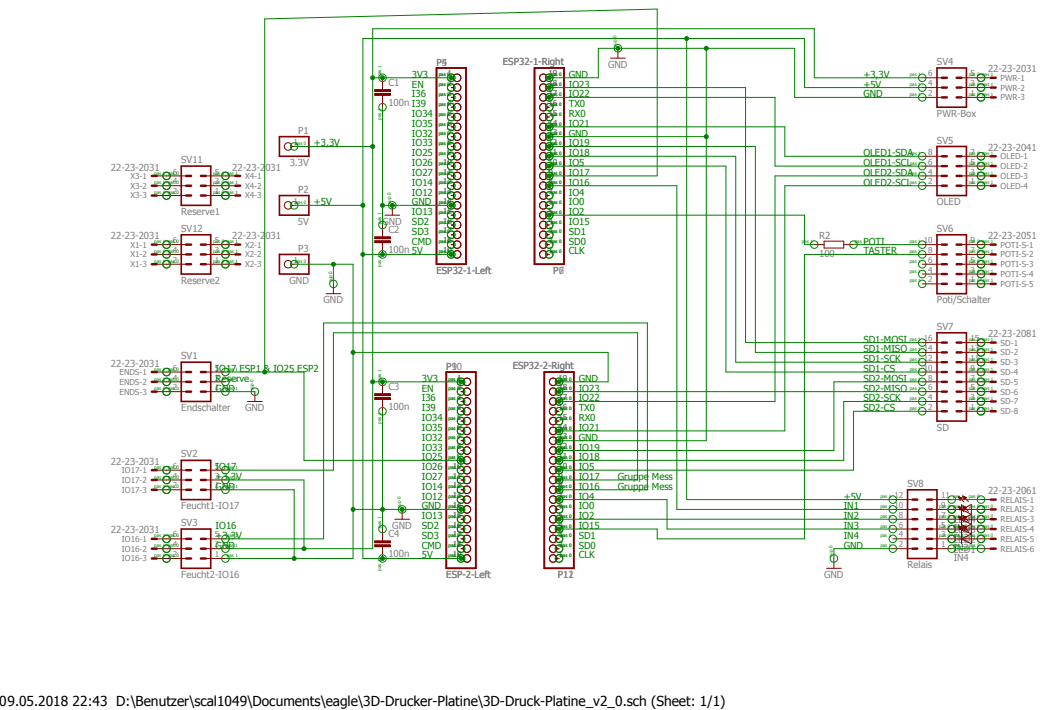
[picture p60: page 1]

pas 1 pas 1

pas 1 pas 1 pas 1 pas 1 pas 1 pas 1 pas 1 pas 1
