MightyMirko/SS2018_HIT_web/data/20180405_eagle_platinenMajo_rev1/3D-Druck-Platine.brd

## EAGLE design data/20180405_eagle_platinenMajo_rev1/3D-Druck-Platine.brd (2018-04-05)

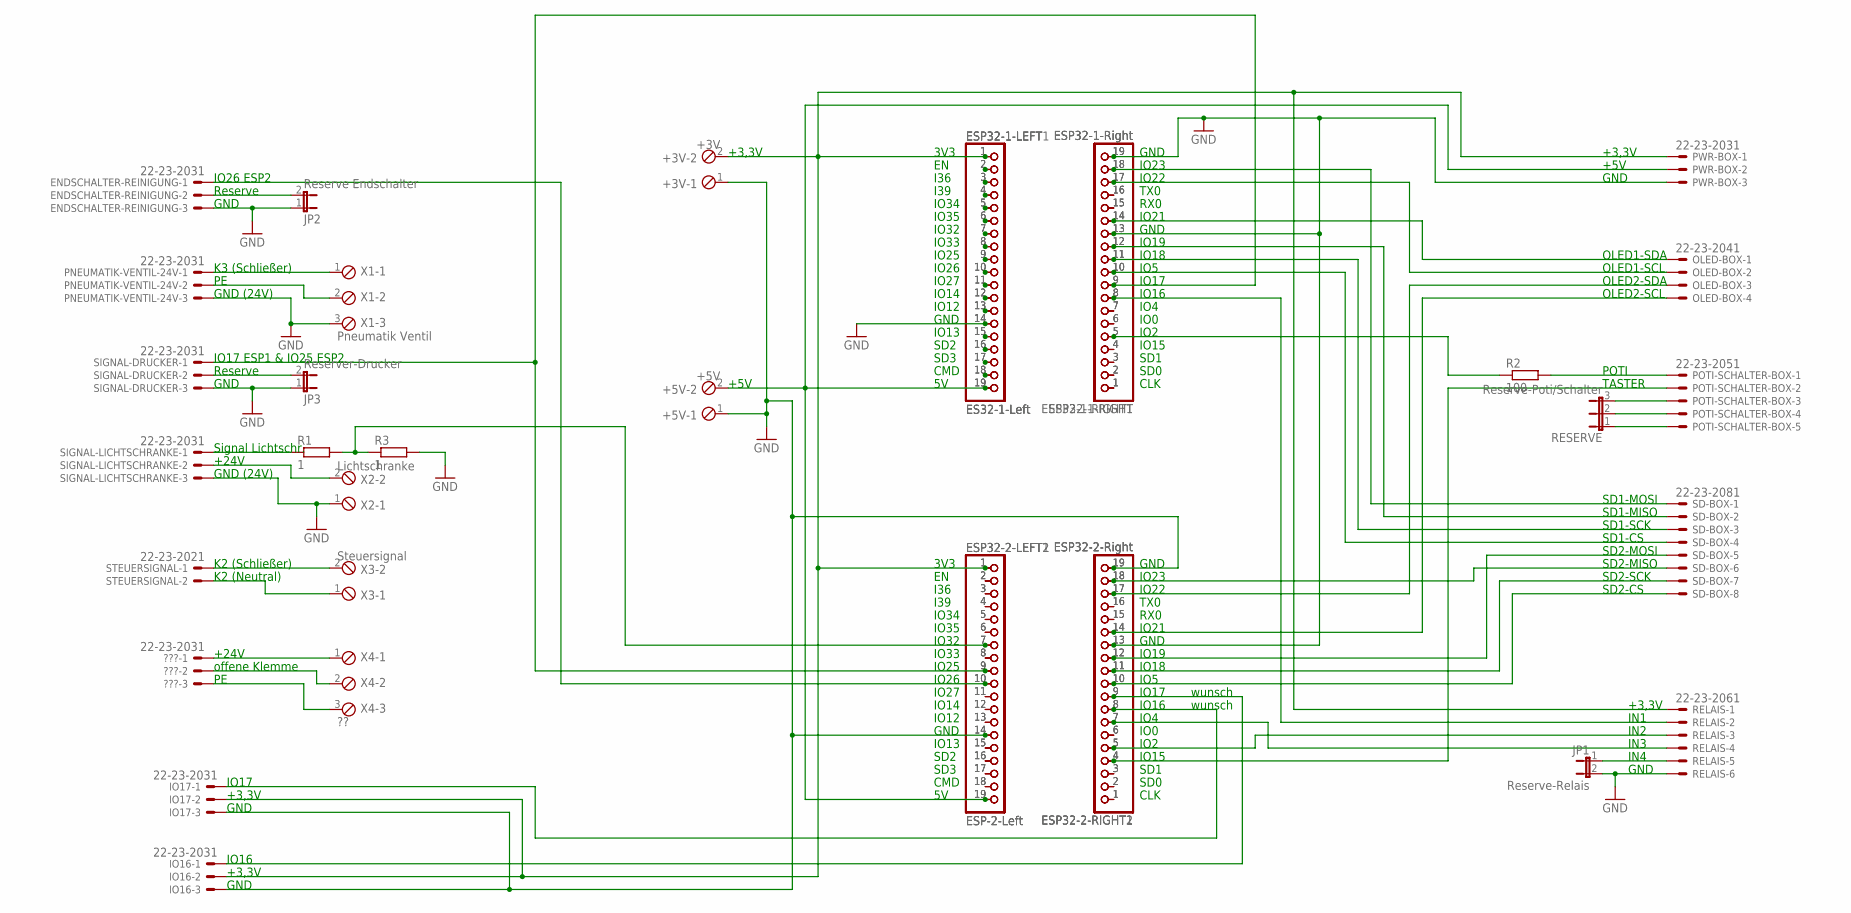
[picture p61: schematic 3D-Druck-Platine.sch]

Parts:
+3V: +3V; 2POL254
+5V: +5V; 2POL254
???: 22-23-2031
ENDSCHALTER-REINIGUNG: 22-23-2031
ESP32-1-LEFT, ESP32-1-LEFT1: ES32-1-Left; 1X19
ESP32-1-RIGHT, ESP32-1-RIGHT1: ESP32-1-Right; 1X19
ESP32-2-LEFT1, ESP32-2-LEFT2: ESP-2-Left; 1X19
ESP32-2-RIGHT1, ESP32-2-RIGHT2: ESP32-2-Right; 1X19
IO16, IO17: 22-23-2031
JP1: Reserve-Relais; JP1
JP2: Reserve Endschalter; JP1
JP3: Reserver-Drucker; JP1
OLED-BOX: 22-23-2041
PNEUMATIK-VENTIL-24V: 22-23-2031
POTI-SCHALTER-BOX: 22-23-2051
PWR-BOX: 22-23-2031
R1, R3: 1; 0207/10
R2: 100; 0207/10
RELAIS: 22-23-2061
RESERVE: Reserve-Poti/Schalter; JP2
SD-BOX: 22-23-2081
SIGNAL-DRUCKER: 22-23-2031
SIGNAL-LICHTSCHRANKE: 22-23-2031
STEUERSIGNAL: 22-23-2021
X1: Pneumatik Ventil; 3POL254
X2: Lichtschranke; 2POL254
X3: Steuersignal; 2POL254
X4: ??; 3POL254

Connections:
GND: +3V.1, +5V.1, ENDSCHALTER-REINIGUNG.3, ESP32-1-LEFT.14, ESP32-1-LEFT1.14, ESP32-1-RIGHT.13, ESP32-1-RIGHT.19, ESP32-1-RIGHT1.13, ESP32-1-RIGHT1.19, ESP32-2-LEFT1.14, ESP32-2-LEFT2.14, ESP32-2-RIGHT1.13, ESP32-2-RIGHT1.19, ESP32-2-RIGHT2.13, ESP32-2-RIGHT2.19, IO16.3, IO17.3, JP1.2, JP2.1, JP3.1, PNEUMATIK-VENTIL-24V.3, PWR-BOX.3, R3.2, RELAIS.6, SIGNAL-DRUCKER.3, SIGNAL-LICHTSCHRANKE.3, X1.3, X2.1
unnamed: ESP32-1-LEFT.2, ESP32-1-LEFT1.2
unnamed: POTI-SCHALTER-BOX.3, RESERVE.3
unnamed: ESP32-1-LEFT.3, ESP32-1-LEFT1.3
unnamed: +3V.2, ESP32-1-LEFT.1, ESP32-1-LEFT1.1, ESP32-2-LEFT1.1, ESP32-2-LEFT2.1, IO16.2, IO17.2, PWR-BOX.1, RELAIS.1
unnamed: POTI-SCHALTER-BOX.4, RESERVE.2
unnamed: POTI-SCHALTER-BOX.5, RESERVE.1
unnamed: +5V.2, ESP32-1-LEFT.19, ESP32-1-LEFT1.19, ESP32-2-LEFT1.19, ESP32-2-LEFT2.19, PWR-BOX.2
unnamed: ESP32-1-LEFT.4, ESP32-1-LEFT1.4
unnamed: ESP32-1-LEFT.5, ESP32-1-LEFT1.5
unnamed: ENDSCHALTER-REINIGUNG.2, JP2.2
unnamed: ESP32-1-LEFT.6, ESP32-1-LEFT1.6
unnamed: JP3.2, SIGNAL-DRUCKER.2
unnamed: R1.1, SIGNAL-LICHTSCHRANKE.1
unnamed: SIGNAL-LICHTSCHRANKE.2, X2.2
unnamed: PNEUMATIK-VENTIL-24V.1, X1.1
unnamed: STEUERSIGNAL.1, X3.2
unnamed: STEUERSIGNAL.2, X3.1
unnamed: PNEUMATIK-VENTIL-24V.2, X1.2
unnamed: ???.1, X4.1
unnamed: ???.2, X4.2
unnamed: ???.3, X4.3
unnamed: JP1.1, RELAIS.5
unnamed: ESP32-1-LEFT.7, ESP32-1-LEFT1.7
unnamed: ESP32-1-LEFT.8, ESP32-1-LEFT1.8
unnamed: ESP32-1-LEFT.9, ESP32-1-LEFT1.9
unnamed: ESP32-1-LEFT.10, ESP32-1-LEFT1.10
unnamed: ESP32-1-LEFT.11, ESP32-1-LEFT1.11
unnamed: ESP32-1-LEFT.12, ESP32-1-LEFT1.12
unnamed: ESP32-1-LEFT.13, ESP32-1-LEFT1.13
unnamed: ESP32-1-LEFT.15, ESP32-1-LEFT1.15
unnamed: ESP32-1-LEFT.16, ESP32-1-LEFT1.16
unnamed: ESP32-1-LEFT.17, ESP32-1-LEFT1.17
unnamed: ESP32-1-LEFT.18, ESP32-1-LEFT1.18
unnamed: ESP32-1-RIGHT.1, ESP32-1-RIGHT1.1
unnamed: ESP32-1-RIGHT.2, ESP32-1-RIGHT1.2
unnamed: ESP32-1-RIGHT.3, ESP32-1-RIGHT1.3
unnamed: ESP32-1-RIGHT.4, ESP32-1-RIGHT1.4
unnamed: ESP32-1-RIGHT.7, ESP32-1-RIGHT1.7
unnamed: ESP32-1-RIGHT.15, ESP32-1-RIGHT1.15
unnamed: ESP32-1-RIGHT.16, ESP32-1-RIGHT1.16
unnamed: ESP32-2-LEFT1.2, ESP32-2-LEFT2.2
unnamed: ESP32-2-LEFT1.3, ESP32-2-LEFT2.3
unnamed: ESP32-2-LEFT1.4, ESP32-2-LEFT2.4
unnamed: ESP32-2-LEFT1.5, ESP32-2-LEFT2.5
unnamed: ESP32-2-LEFT1.6, ESP32-2-LEFT2.6
unnamed: ESP32-2-LEFT1.8, ESP32-2-LEFT2.8
unnamed: ESP32-2-LEFT1.11, ESP32-2-LEFT2.11
unnamed: ESP32-2-LEFT1.12, ESP32-2-LEFT2.12
unnamed: ESP32-2-LEFT1.13, ESP32-2-LEFT2.13
unnamed: ESP32-2-LEFT1.15, ESP32-2-LEFT2.15
unnamed: ESP32-2-LEFT1.16, ESP32-2-LEFT2.16
unnamed: ESP32-2-LEFT1.17, ESP32-2-LEFT2.17
unnamed: ESP32-2-LEFT1.18, ESP32-2-LEFT2.18
unnamed: ESP32-2-RIGHT1.1, ESP32-2-RIGHT2.1
unnamed: ESP32-2-RIGHT1.2, ESP32-2-RIGHT2.2
unnamed: ESP32-2-RIGHT1.3, ESP32-2-RIGHT2.3
unnamed: ESP32-2-RIGHT1.6, ESP32-2-RIGHT2.6
unnamed: ESP32-2-RIGHT1.15, ESP32-2-RIGHT2.15
unnamed: POTI-SCHALTER-BOX.1, R2.2
unnamed: ESP32-1-RIGHT.6, ESP32-1-RIGHT1.6
unnamed: ESP32-2-RIGHT1.16, ESP32-2-RIGHT2.16
N$ESP1-18: ESP32-1-RIGHT.11, ESP32-1-RIGHT1.11, SD-BOX.3
N$ESP1-IO2: ESP32-1-RIGHT.5, ESP32-1-RIGHT1.5, R2.1
N$ESP1-IO5: ESP32-1-RIGHT.10, ESP32-1-RIGHT1.10, SD-BOX.4
N$ESP1-IO16: ESP32-1-RIGHT.8, ESP32-1-RIGHT1.8, RELAIS.2
N$ESP1-IO17_ESP2-IO25: ESP32-1-RIGHT.9, ESP32-1-RIGHT1.9, ESP32-2-LEFT1.9, ESP32-2-LEFT2.9, SIGNAL-DRUCKER.1
N$ESP1-IO19: ESP32-1-RIGHT.12, ESP32-1-RIGHT1.12, SD-BOX.2
N$ESP1-IO21: ESP32-1-RIGHT.14, ESP32-1-RIGHT1.14, OLED-BOX.1
N$ESP1-IO22: ESP32-1-RIGHT.17, ESP32-1-RIGHT1.17, OLED-BOX.2
N$ESP1-IO23: ESP32-1-RIGHT.18, ESP32-1-RIGHT1.18, SD-BOX.1
N$ESP2-IO2: ESP32-2-RIGHT1.5, ESP32-2-RIGHT2.5, RELAIS.3
N$ESP2-IO4: ESP32-2-RIGHT1.7, ESP32-2-RIGHT2.7, RELAIS.4
N$ESP2-IO5: ESP32-2-RIGHT1.10, ESP32-2-RIGHT2.10, SD-BOX.8
N$ESP2-IO15: ESP32-2-RIGHT1.4, ESP32-2-RIGHT2.4, POTI-SCHALTER-BOX.2
N$ESP2-IO16: ESP32-2-RIGHT1.8, ESP32-2-RIGHT2.8, IO17.1
N$ESP2-IO17: ESP32-2-RIGHT1.9, ESP32-2-RIGHT2.9, IO16.1
N$ESP2-IO18: ESP32-2-RIGHT1.11, ESP32-2-RIGHT2.11, SD-BOX.7
N$ESP2-IO19: ESP32-2-RIGHT1.12, ESP32-2-RIGHT2.12, SD-BOX.5
N$ESP2-IO21: ESP32-2-RIGHT1.14, ESP32-2-RIGHT2.14, OLED-BOX.4
N$ESP2-IO22: ESP32-2-RIGHT1.17, ESP32-2-RIGHT2.17, OLED-BOX.3
N$ESP2-IO23: ESP32-2-RIGHT1.18, ESP32-2-RIGHT2.18, SD-BOX.6
N$ESP2-IO26: ENDSCHALTER-REINIGUNG.1, ESP32-2-LEFT1.10, ESP32-2-LEFT2.10
N$ESP2-IO32: ESP32-2-LEFT1.7, ESP32-2-LEFT2.7, R1.2, R3.1

Notes on the sheet:
3V3
I36
I39
IO34
IO35
IO32
IO33
IO25
IO26
IO27
IO14
IO12
GND
IO13
SD2
SD3
CMD
IO23
IO22
TX0
RX0
IO21
IO18
IO19
IO5
IO17
IO16
IO4
IO0
IO2
IO15
SD1
SD0
CLK
+5V
+3,3V
OLED1-SDA
OLED2-SDA
OLED2-SCL
OLED1-SCL
SD1-MOSI
SD2-MOSI
SD2-MISO
SD1-MISO
SD1-SCK
SD2-SCK
SD2-CS
SD1-CS
POTI
TASTER
IN1
IN2
IN3
IN4
+24V
IO26 ESP2
Reserve
IO17 ESP1 & IO25 ESP2
Signal Lichtschr.
GND (24V)
K2 (Schließer)
K2 (Neutral)
K3 (Schließer)
offene Klemme
wunsch

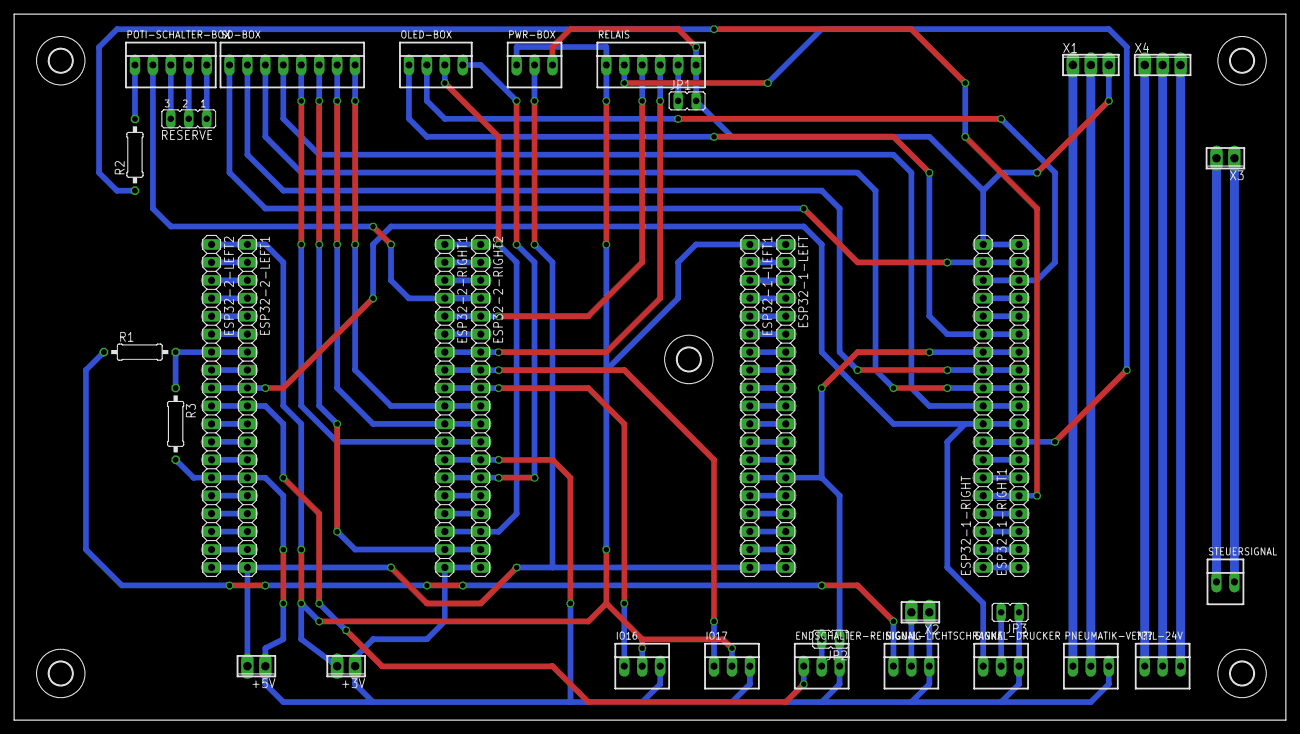
[picture p62: board 3D-Druck-Platine.brd from above]

Board: 1 copper layer, 180.0 x 99.9 mm, 39 parts (0 on the bottom side), 84 nets.

Other parts of the board:
U$1, U$2, U$3, U$4, U$5: 3,3
