MightyMirko/SS2018_HIT_web/data/20180520_eagle_platinenMajo_rev2/3D-Druck-Platine_v2_0.brd

## EAGLE design data/20180520_eagle_platinenMajo_rev2/3D-Druck-Platine_v2_0.brd (2018-05-20)

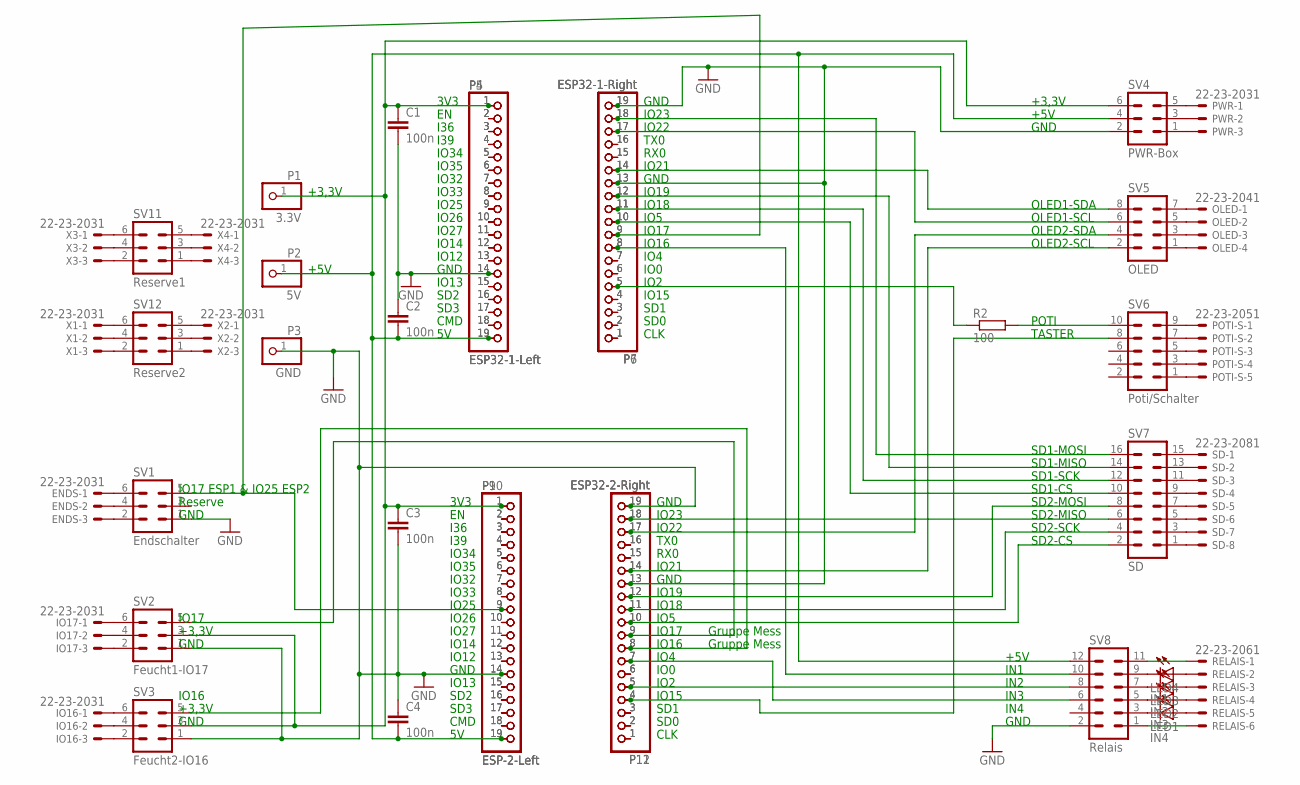
[picture p63: schematic 3D-Druck-Platine_v2_0.sch]

Parts:
C1, C2, C3, C4: 100n; C025-024X044
ENDS: 22-23-2031
IO16, IO17: 22-23-2031
LED1: IN4; LED3MM
LED2: IN3; LED3MM
LED3: IN2; LED3MM
LED4: IN1; LED3MM
OLED: 22-23-2041
P1: 3.3V; 1X01
P2: 5V; 1X01
P3: GND; 1X01
P4, P5: ESP32-1-Left; 1X19
P6, P7: ESP32-1-Right; 1X19
P9, P10: ESP-2-Left; 1X19
P11, P12: ESP32-2-Right; 1X19
POTI-S: 22-23-2051
PWR: 22-23-2031
R2: 100; 0207/10
RELAIS: 22-23-2061
SD: 22-23-2081
SV1: Endschalter; MA03-2
SV2: Feucht1-IO17; MA03-2
SV3: Feucht2-IO16; MA03-2
SV4: PWR-Box; MA03-2
SV5: OLED; MA04-2
SV6: Poti/Schalter; MA05-2
SV7: SD; MA08-2
SV8: Relais; MA06-2
SV11: Reserve1; MA03-2
SV12: Reserve2; MA03-2
X1, X2, X3, X4: 22-23-2031

Connections:
GND: C1.2, C2.1, C3.2, C4.1, P3.1, P4.14, P5.14, P6.13, P6.19, P7.13, P7.19, P9.14, P10.14, P11.13, P11.19, P12.13, P12.19, SV1.1, SV2.1, SV3.1, SV4.2, SV8.2
unnamed: P4.2, P5.2
unnamed: LED4.K (C), SV8.9
unnamed: P4.3, P5.3
unnamed: C1.1, C3.1, P1.1, P4.1, P5.1, P9.1, P10.1, SV2.3, SV3.3, SV4.6
unnamed: P11.8, P12.8, SV3.5
unnamed: LED3.K (C), SV8.7
unnamed: C2.2, C4.2, P2.1, P4.19, P5.19, P9.19, P10.19, SV4.4, SV8.12
unnamed: P4.4, P5.4
unnamed: P4.5, P5.5
unnamed: ENDS.1, SV1.6
unnamed: P4.6, P5.6
unnamed: IO17.1, SV2.6
unnamed: ENDS.2, SV1.4
unnamed: ENDS.3, SV1.2
unnamed: IO17.2, SV2.4
unnamed: IO17.3, SV2.2
unnamed: IO16.1, SV3.6
unnamed: IO16.2, SV3.4
unnamed: IO16.3, SV3.2
unnamed: PWR.1, SV4.5
unnamed: PWR.2, SV4.3
unnamed: LED2.K (C), SV8.5
unnamed: P4.7, P5.7
unnamed: P4.8, P5.8
unnamed: P4.9, P5.9
unnamed: P4.10, P5.10
unnamed: P4.11, P5.11
unnamed: P4.12, P5.12
unnamed: P4.13, P5.13
unnamed: P4.15, P5.15
unnamed: P4.16, P5.16
unnamed: P4.17, P5.17
unnamed: P4.18, P5.18
unnamed: P6.1, P7.1
unnamed: P6.2, P7.2
unnamed: P6.3, P7.3
unnamed: P6.4, P7.4
unnamed: PWR.3, SV4.1
unnamed: P6.7, P7.7
unnamed: P6.15, P7.15
unnamed: P6.16, P7.16
unnamed: P9.2, P10.2
unnamed: P9.3, P10.3
unnamed: P9.4, P10.4
unnamed: P9.5, P10.5
unnamed: P9.6, P10.6
unnamed: P9.8, P10.8
unnamed: P9.11, P10.11
unnamed: P9.12, P10.12
unnamed: P9.13, P10.13
unnamed: P9.15, P10.15
unnamed: P9.16, P10.16
unnamed: P9.17, P10.17
unnamed: P9.18, P10.18
unnamed: P11.1, P12.1
unnamed: P11.2, P12.2
unnamed: P11.3, P12.3
unnamed: OLED.1, SV5.7
unnamed: P11.6, P12.6
unnamed: P11.15, P12.15
unnamed: R2.2, SV6.10
unnamed: P6.6, P7.6
unnamed: OLED.2, SV5.5
unnamed: OLED.3, SV5.3
unnamed: OLED.4, SV5.1
unnamed: POTI-S.1, SV6.9
unnamed: POTI-S.2, SV6.7
unnamed: POTI-S.3, SV6.5
unnamed: POTI-S.4, SV6.3
unnamed: POTI-S.5, SV6.1
unnamed: SD.1, SV7.15
unnamed: SD.2, SV7.13
unnamed: SD.3, SV7.11
unnamed: SD.5, SV7.7
unnamed: SD.6, SV7.5
unnamed: SD.7, SV7.3
unnamed: SD.8, SV7.1
unnamed: SD.4, SV7.9
unnamed: RELAIS.1, SV8.11
unnamed: LED1.K (C), SV8.3
unnamed: LED4.A, RELAIS.2
unnamed: LED3.A, RELAIS.3
unnamed: LED2.A, RELAIS.4
unnamed: RELAIS.6, SV8.1
unnamed: LED1.A, RELAIS.5
unnamed: SV11.6, X3.1
unnamed: SV11.4, X3.2
unnamed: SV11.2, X3.3
unnamed: SV11.5, X4.1
unnamed: SV11.3, X4.2
unnamed: SV11.1, X4.3
unnamed: SV12.6, X1.1
unnamed: SV12.4, X1.2
unnamed: SV12.2, X1.3
unnamed: SV12.5, X2.1
unnamed: SV12.3, X2.2
unnamed: SV12.1, X2.3
unnamed: P11.16, P12.16
N$ESP1-18: P6.11, P7.11, SV7.12
N$ESP1-IO2: P6.5, P7.5, R2.1
N$ESP1-IO5: P6.10, P7.10, SV7.10
N$ESP1-IO16: P6.8, P7.8, SV8.10
N$ESP1-IO17_ESP2-IO25: P6.9, P7.9, P9.9, P10.9, SV1.5
N$ESP1-IO19: P6.12, P7.12, SV7.14
N$ESP1-IO21: P6.14, P7.14, SV5.8
N$ESP1-IO22: P6.17, P7.17, SV5.6
N$ESP1-IO23: P6.18, P7.18, SV7.16
N$ESP2-IO2: P11.5, P12.5, SV8.8
N$ESP2-IO4: P11.7, P12.7, SV8.6
N$ESP2-IO5: P11.10, P12.10, SV7.2
N$ESP2-IO15: P11.4, P12.4, SV6.8
N$ESP2-IO16: P11.9, P12.9, SV2.5
N$ESP2-IO18: P11.11, P12.11, SV7.4
N$ESP2-IO19: P11.12, P12.12, SV7.8
N$ESP2-IO21: P11.14, P12.14, SV5.2
N$ESP2-IO22: P11.17, P12.17, SV5.4
N$ESP2-IO23: P11.18, P12.18, SV7.6
N$ESP2-IO26: P9.10, P10.10
N$ESP2-IO32: P9.7, P10.7

Notes on the sheet:
3V3
I36
I39
IO34
IO35
IO32
IO33
IO25
IO26
IO27
IO14
IO12
GND
IO13
SD2
SD3
CMD
IO23
IO22
TX0
RX0
IO21
IO18
IO19
IO5
IO17
IO16
IO4
IO0
IO2
IO15
SD1
SD0
CLK
+5V
+3,3V
OLED1-SDA
OLED2-SDA
OLED2-SCL
OLED1-SCL
SD1-MOSI
SD2-MOSI
SD2-MISO
SD1-MISO
SD1-SCK
SD2-SCK
SD2-CS
SD1-CS
POTI
TASTER
IN1
IN2
IN3
IN4
IO17 ESP1 & IO25 ESP2
Reserve
Gruppe Mess

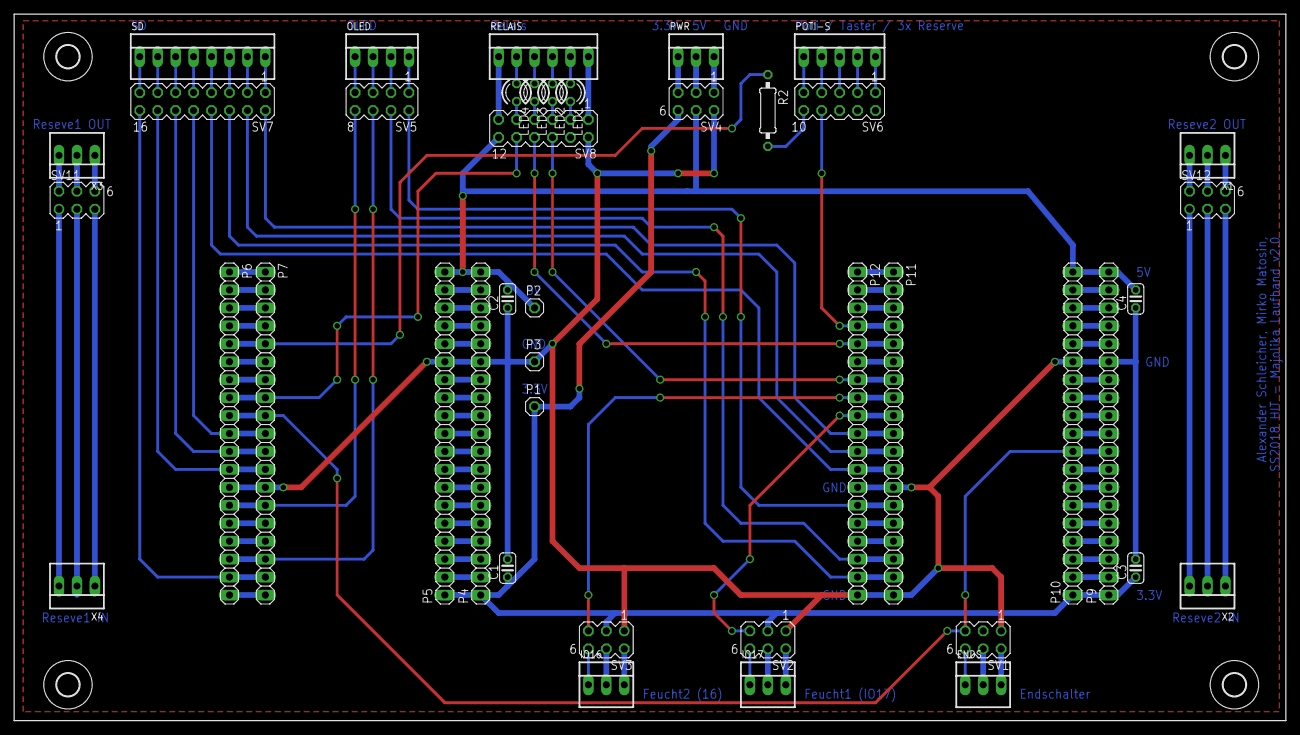
[picture p64: board 3D-Druck-Platine_v2_0.brd from above]

Board: 2 copper layers, 180.0 x 100.0 mm, 46 parts (0 on the bottom side), 120 nets.

Other parts of the board:
U$1, U$2, U$3, U$4: 3,2
