MightyMirko/SS2018_HIT_web/(commit log)

2018-04-05 layout und eagle zip hinzefügt. Stand der TEchnik verbessert und die calc sheets umbenannt und eingebettet.
    [20180315_BoM_MajoPlatine.xlsx, 3D-Druck-Platine.brd, 3D-Druck-Platine.sch, Anforderungsliste.xlsx, Bestellliste.xlsx, BestelllisteGeordnetNachShopFordertechnik.xlsx, Board.brd, ISTProjektplan.xlsx]
2018-04-10 BoM Download hinzugefügt. EagleZip gefixt.
2018-04-10 Bis Stand der Technik - Punkt Quelle, yt Größe, bild fehlt,
2018-04-18 Anleitung und Protokolle gepatcht. Stand der Technik vom letzten Commit steht noch aus Vorlage.dwt wurde auf utf-8 geändert. Dadurch kann man nun Umlaute nutzen.
2018-04-18 Design.css und portbelegungsplan geändert per Hand
2018-04-18 Portbelegungsplan erfolgreich angepasst. Navigationsstrukturen wurden automatisch von Expression Web4 gemerget - #TODO Checke di eNav Struktur
    [20180315_BoM_MajoPlatine.xlsx, 3D-Druck-Platine.brd, 3D-Druck-Platine.sch, Anforderungsliste.xlsx, Bestellliste.xlsx, BestelllisteGeordnetNachShopFordertechnik.xlsx, Board.brd, ISTProjektplan.xlsx]
2018-04-18 removed fucking vti
    [20180315_BoM_MajoPlatine.xlsx, 3D-Druck-Platine.brd, 3D-Druck-Platine.sch, Anforderungsliste.xlsx, Bestellliste.xlsx, BestelllisteGeordnetNachShopFordertechnik.xlsx, Board.brd, ISTProjektplan.xlsx]
2018-04-18 Aufrauemen unbenötigter Dateien - default.css?
    [Bestellliste.xlsx, Board.brd, ISTProjektplan.xlsx, Rechentabelle-Verfahrensmatrix.xls, Sinus.xlsx, schaltplan.sch]
2018-04-18 Betastatus erreicht. Vorlage.dwt geändert - jetzt ist es breiter. Dies ist für die Vorlesungen besser
2018-04-18 Hallo GitHub - habe das repo ins Hub abgelegt. Den Link habe ich in die 0412Linkliste.html abgelegt.
2018-04-19 portbelegungsplan angepasst und tabelle verschönert (rahmen)
2018-04-19 Seltsamer Fehler. In der Ausarbeitung fehlt manchmal ein Listeneintrag im DropDownMenu
2018-05-02 0401 0411 upgedated.. Platinenbild ist online.. Momentane Lösung haben wir leider kein Bild von
2018-05-20 Anpassen auf version2.0- Ausgewaehlte Loesungen und Bilder wurden hochgeladen
    [20180520_bom_platineMajo_rev2.xlsx, 3D-Druck-Platine.brd, 3D-Druck-Platine.sch, 3D-Druck-Platine_v2_0.brd, 3D-Druck-Platine_v2_0.sch, Anforderungsliste.xlsx, Bestellliste.xlsx, BestelllisteGeordnetNachShopFordertechnik.xlsx]
